arizonat/softroboticfish7/fish/mbed/README.md

===== saved_bin_files =====  
-- This contains bin files that were used for important experiments/demos.  

===== MCUXpress =====  
-- This is now an MCUXpresso (inherits from LPCXpresso) project for the fish mbed code. Install MCUXpresso IDE and import the workspace directory to edit. 

===== ZIP =====  
-- This contains compressed snapshots of previous mbed codebases.
