arizonat/softroboticfish7/fish/pi/ros/catkin_ws/src/fishstatecontroller/README.md

Defined Coordinates for fish: 
Positive x is the direction from the camera frame to the ball
Positive y is to the left in the camera frame
positive z is upward in the camera frame
