arizonat/softroboticfish7/fish/pi/ros/catkin_ws/src/fishstatecontroller/launch/raspicam_custom/Read Me.txt

Remember to adjust ObjectTracker init parameters for every frame res. change!
