arizonat/softroboticfish7/fish/pi/ros/catkin_ws/src/fishstatecontroller/graphs/lpf2.png

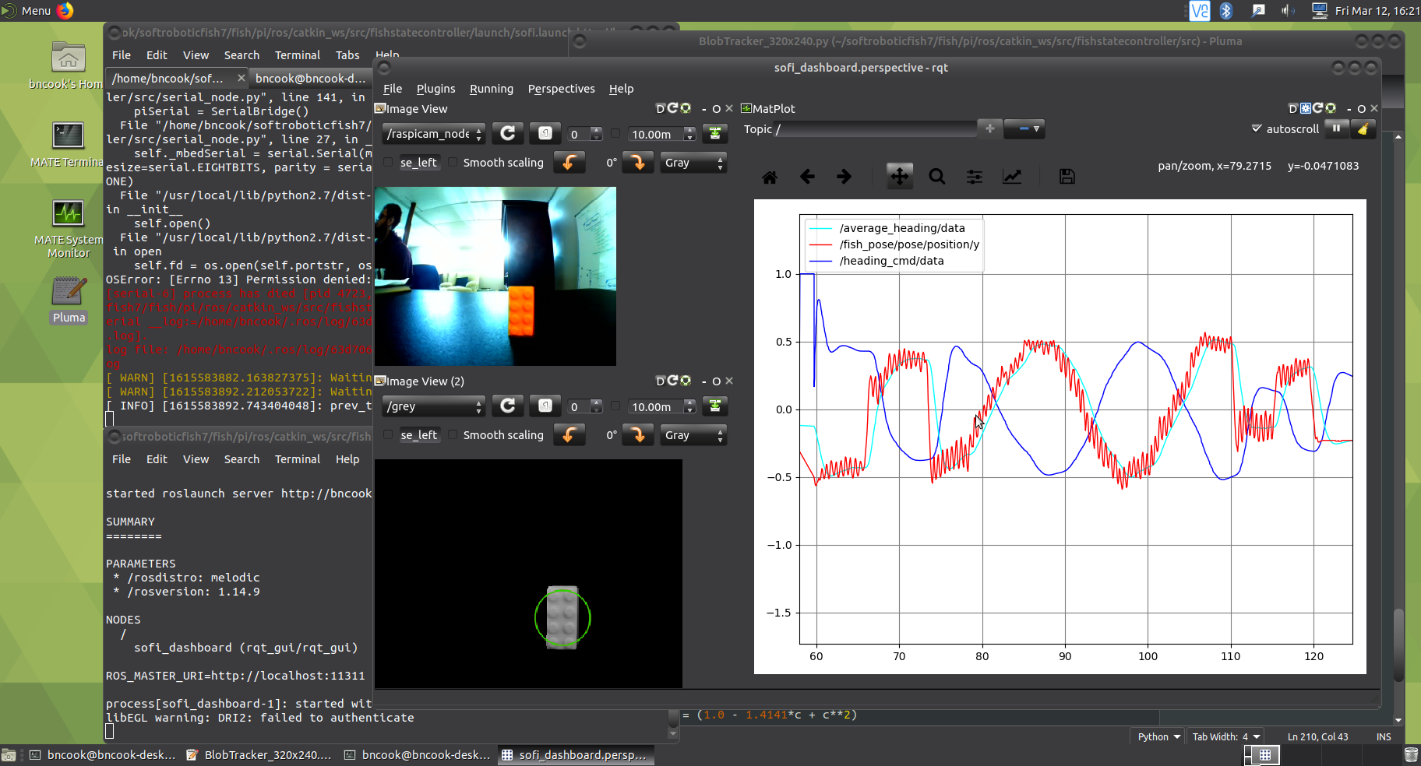
fish/pi/ros/catkin_ws/src/fishstatecontroller/graphs/lpf2.png
