arizonat/softroboticfish7/fish/pi/ros/catkin_ws/src/fishstatecontroller/graphs/lpf.png

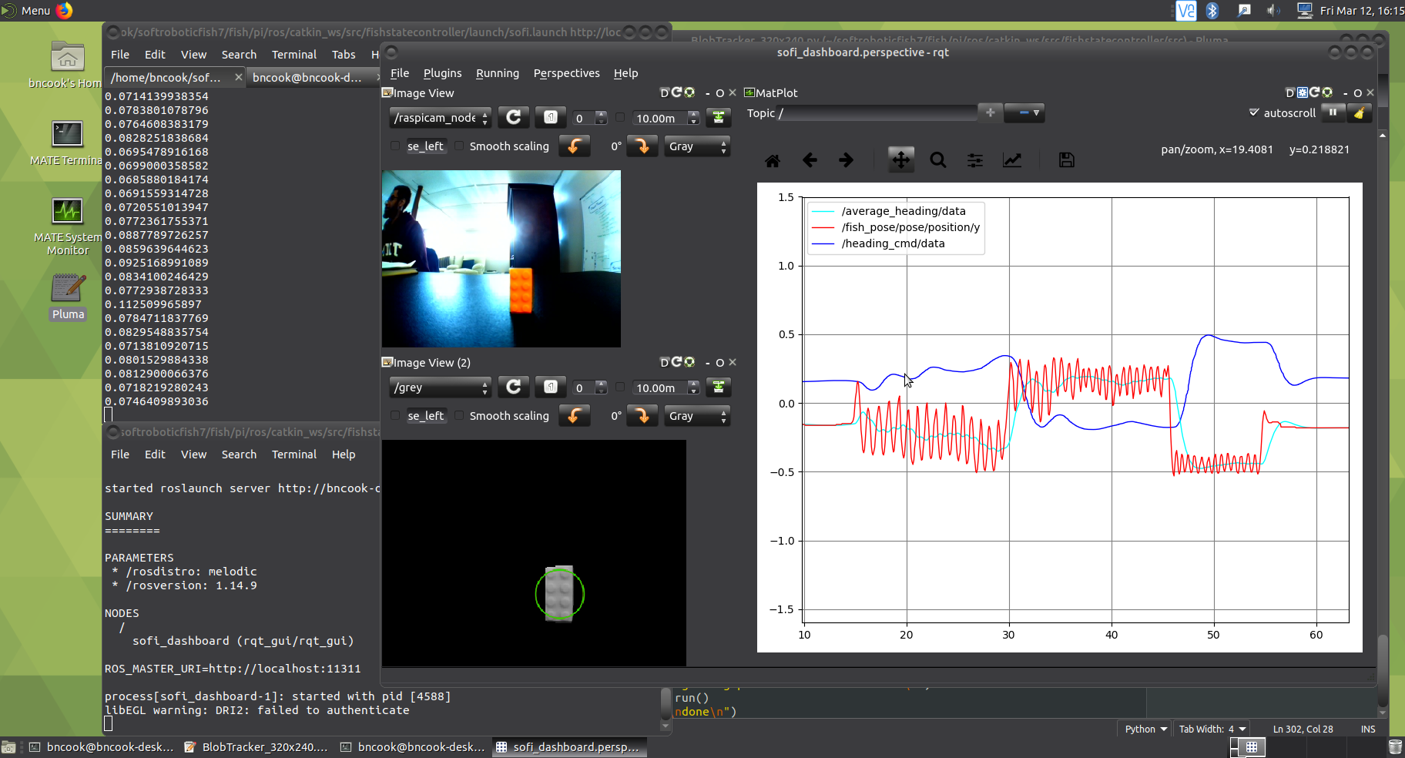
fish/pi/ros/catkin_ws/src/fishstatecontroller/graphs/lpf.png
