arizonat/softroboticfish7/fish/pi/ros/catkin_ws/src/fishstatecontroller/graphs/lpf_est_side.png

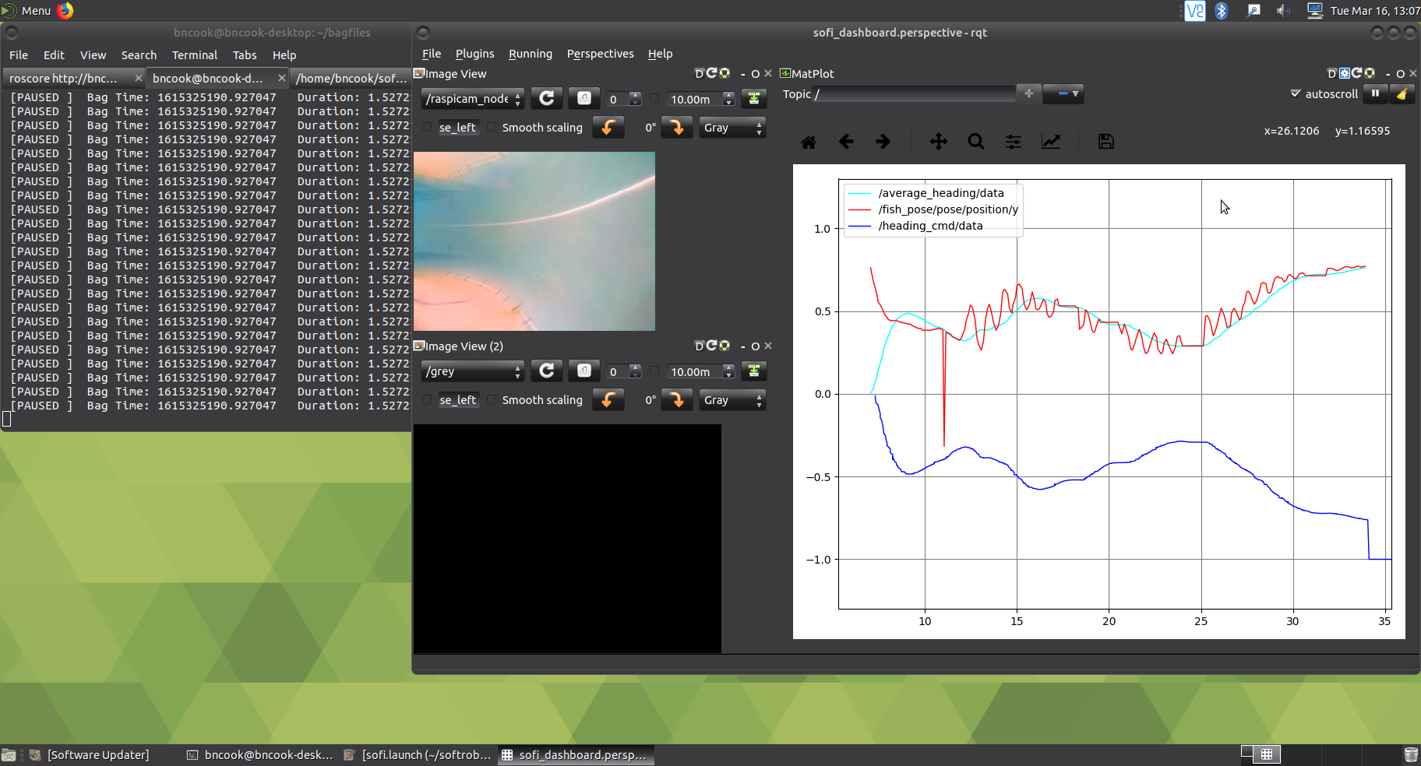
fish/pi/ros/catkin_ws/src/fishstatecontroller/graphs/lpf_est_side.png
