arizonat/softroboticfish7/fish/pi/ros/catkin_ws/src/fishstatecontroller/graphs/Screenshot at 2021-03-05 15-20-54.png

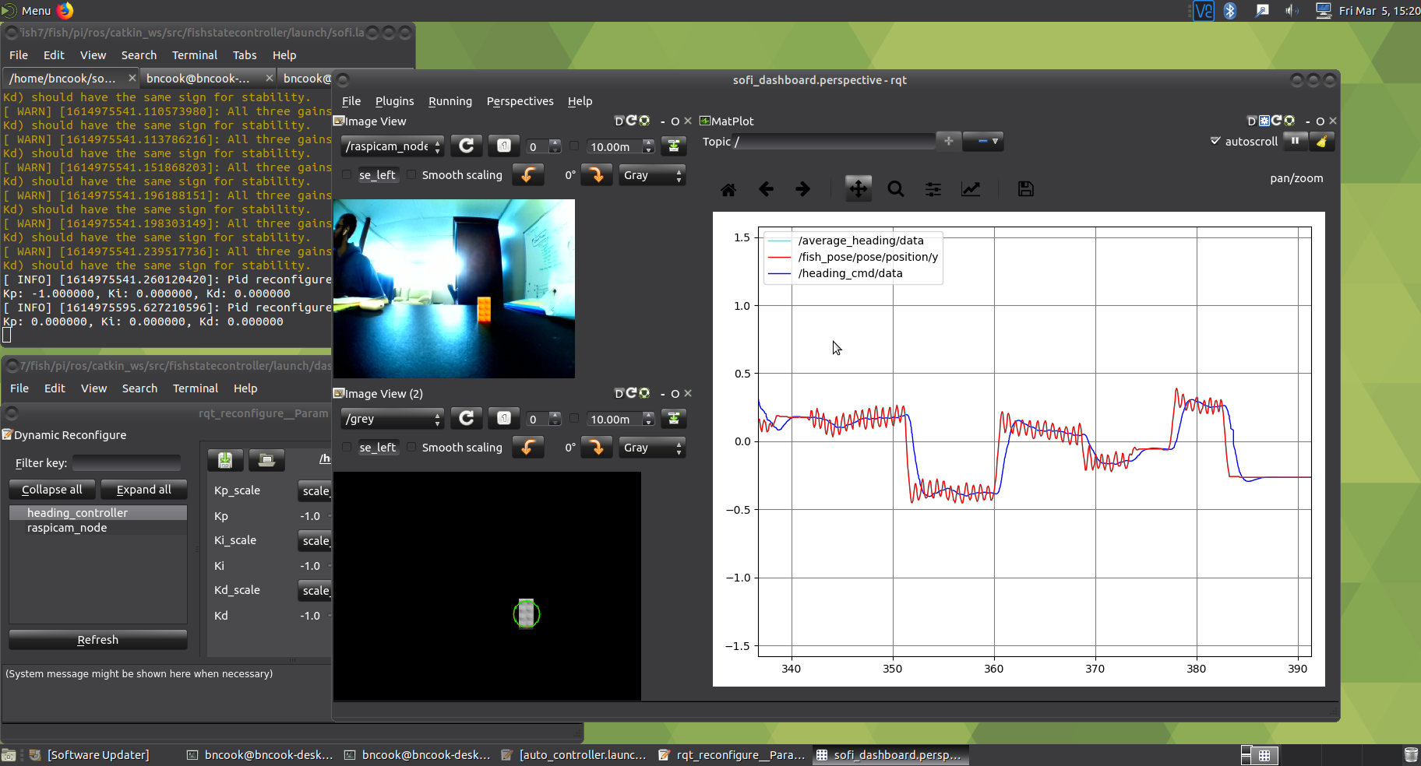
fish/pi/ros/catkin_ws/src/fishstatecontroller/graphs/Screenshot at 2021-03-05 15-20-54.png
