arizonat/softroboticfish7/hardware/Projects/SRF V2/V2_1 (DRV8801)/Images/Bottom.png

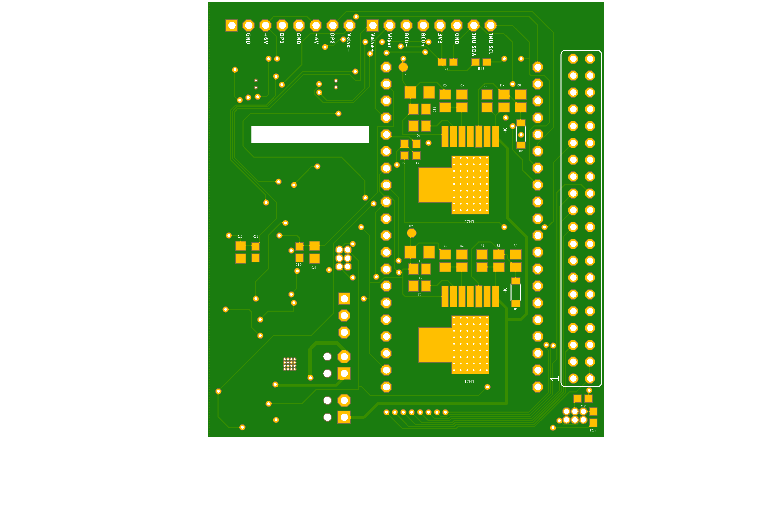
hardware/Projects/SRF V2/V2_1 (DRV8801)/Images/Bottom.png
