arizonat/softroboticfish7/hardware/Projects/SRF V2/V2_1 (DRV8801)/Images/Top.png

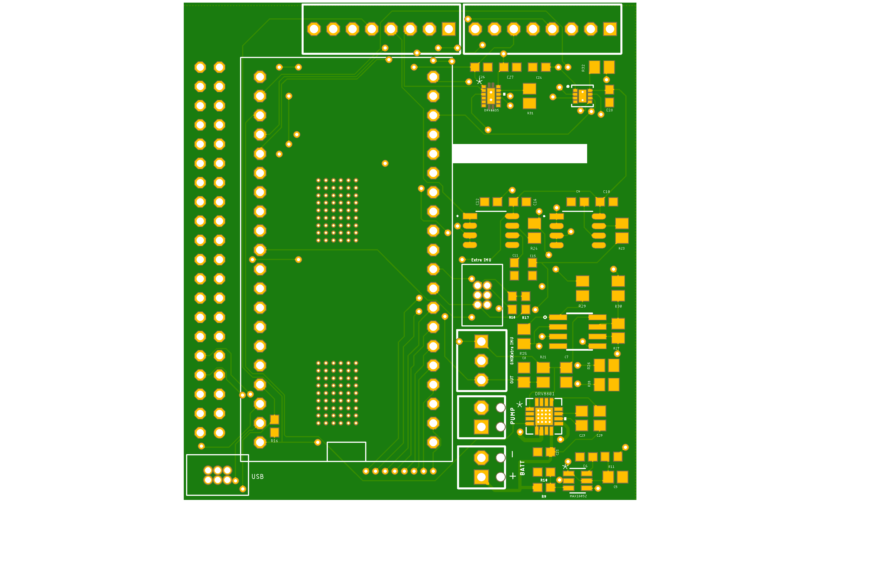
hardware/Projects/SRF V2/V2_1 (DRV8801)/Images/Top.png
