arizonat/softroboticfish7/hardware/Projects/SRF V2/V2_2 (MAX14870)/Long Motor Trace.png

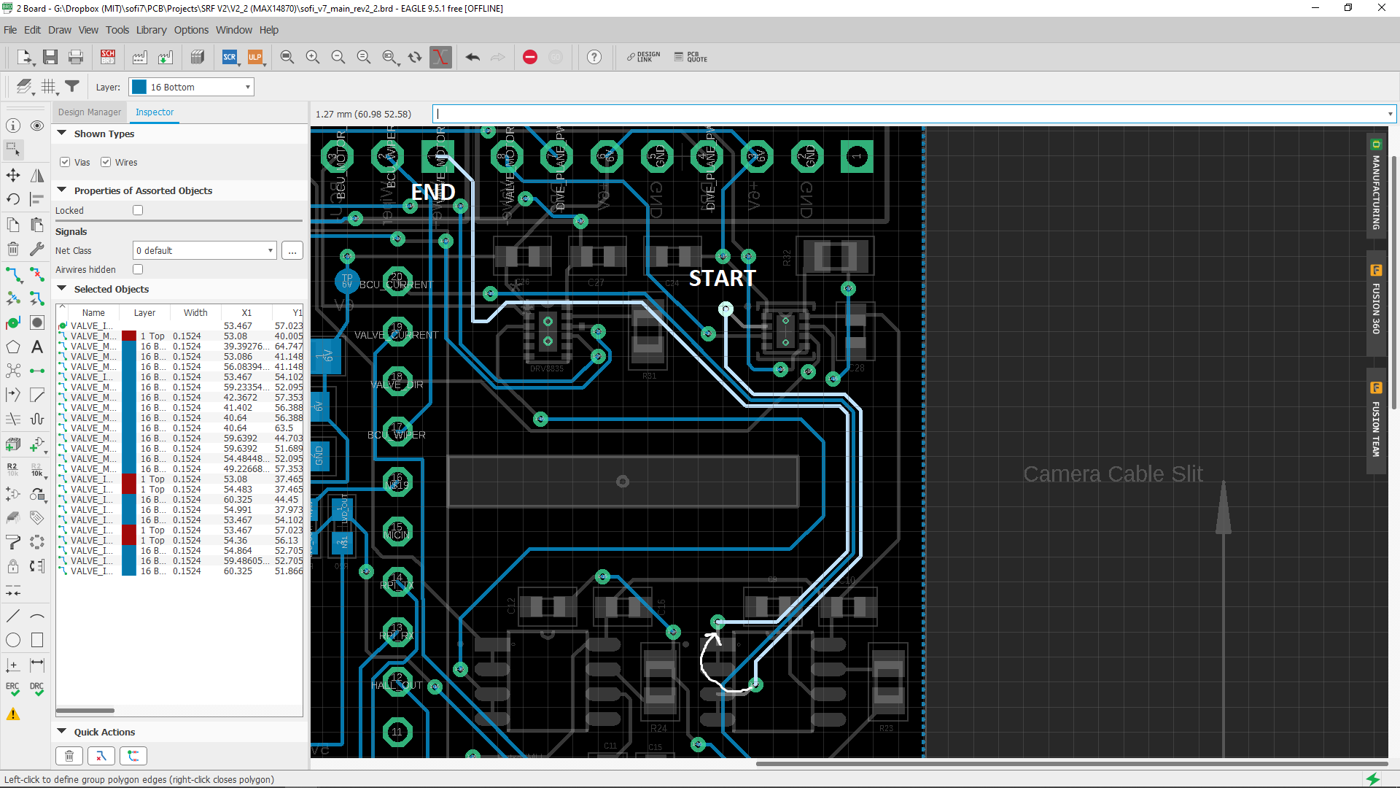
hardware/Projects/SRF V2/V2_2 (MAX14870)/Long Motor Trace.png
