arizonat/softroboticfish7/hardware/Projects/SRF V2/V2_2 (MAX14870)/Power Planes Shot Marked.jpg

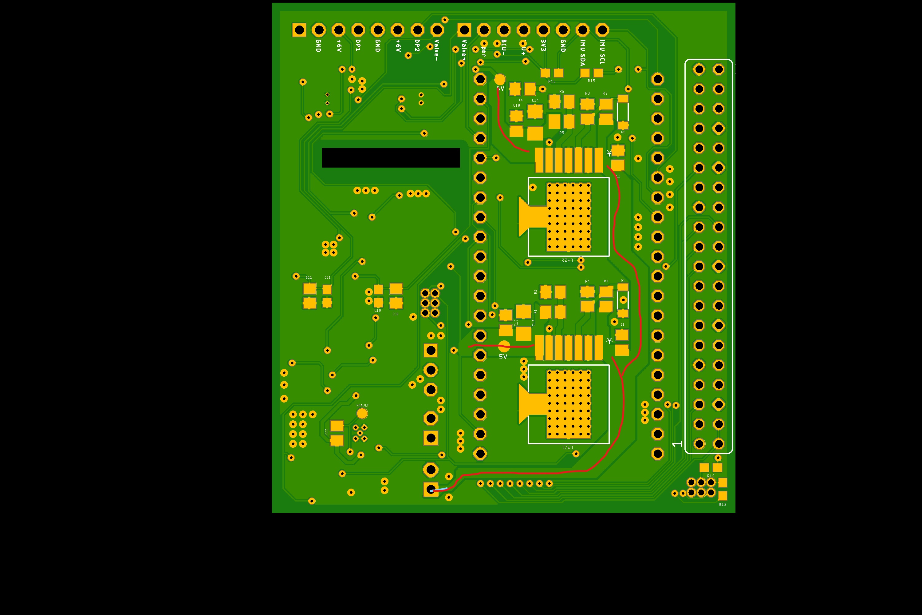
hardware/Projects/SRF V2/V2_2 (MAX14870)/Power Planes Shot Marked.jpg
