arizonat/softroboticfish7/hardware/Projects/SRF V2/V2_2 (MAX14870)/BOM/srfv2_2_BOM.xlsx

Manufacturer Part Number | Manufacturer | Digi-Key Part Number | Customer Reference | Reference Designator | Packaging | Part Status | Quantity | Unit Price | Extended Price | Quantity Available | Mfg Std Lead Time | Description | RoHS Status | Lead Free Status | REACH Status
ACS715LLCTR-20A-T | Allegro MicroSystems | 620-1230-1-ND |  | ACS715_BCU, ACS715_VALVE | Cut Tape (CT) | Not For New Designs | 2 | 6.52 | $13.04 | 3330 | Not Available | SENSOR CURRENT HALL 20A DC | ROHS3 Compliant | Contains lead | REACH Unaffected
45206-600230 | 3M | 3M15533-ND |  | USB | Tray | Active | 2 | 2.1 | $4.20 | 570 | 10 Weeks | CONN HEADER VERT 6POS 1.27MM | ROHS3 Compliant | Lead free | Not Available
DRV8835DSSR | Texas Instruments | 296-30391-2-ND |  | DRV8835 | Tape & Reel (TR) | Active | 1 | 0 | $0.00 | 21000 | 6 Weeks | IC MTR DRVR BIPOLAR 2-7V 12WSON | ROHS3 Compliant | Lead free | REACH Unaffected
DRV8838DSGT | Texas Instruments | 296-37539-1-ND |  | DRV8838 | Cut Tape (CT) | Active | 1 | 1.03 | $1.03 | 3356 | 6 Weeks | IC BRIDGE DRIVER PAR 8WSON | ROHS3 Compliant | Lead free | REACH Unaffected
1725656 | Phoenix Contact | 277-1273-ND |  | BATT, PUMP | Bulk | Active | 2 | 1.41 | $2.82 | 7140 | 7 Weeks | TERM BLK 2P SIDE ENT 2.54MM PCB | RoHS Compliant | Lead free | Not Available
MAX14870ETC+T | Maxim Integrated | MAX14870ETC+CT-ND |  | MAX14870 | Cut Tape (CT) | Active | 1 | 2.51 | $2.51 | 10600 | 7 Weeks | IC MOTOR DRIVER 4.5V-36V 12TDFN | ROHS3 Compliant | Lead free | REACH Unaffected
MAX16052AUT+T | Maxim Integrated | MAX16052AUT+TCT-ND |  | MAX16052 | Cut Tape (CT) | Active | 1 | 2.27 | $2.27 | 15019 | 6 Weeks | IC PWR MONITOR/SEQUENCER SOT23-6 | ROHS3 Compliant | Lead free | REACH Unaffected
PPPC202LFBN-RC | Sullins Connector Solutions | S7123-ND |  | RPI_HEADER | Tray | Active | 1 | 2.03 | $2.03 | 4207 | 5 Weeks | CONN HDR 40POS 0.1 GOLD PCB | ROHS3 Compliant | Lead free | REACH Unaffected
OM11043,598 | NXP USA Inc. | 568-4916-ND |  | MBED | Box | Active | 1 | 52.06 | $52.06 | 0 | 12 Weeks | MBED LPC176X DEV EVAL BRD | ROHS3 Compliant | Lead free | REACH Unaffected
OSTVN08A150 | On Shore Technology Inc. | ED10566-ND |  | U$4, U$5 | Bulk | Active | 2 | 2.01 | $4.02 | 2383 | 8 Weeks | TERM BLK 8P SIDE ENT 2.54MM PCB | ROHS3 Compliant | Lead free | REACH Unaffected
OSTVN03A150 | On Shore Technology Inc. | ED10562-ND |  | HALL | Bulk | Active | 1 | 0.88 | $0.88 | 12192 | 8 Weeks | TERM BLK 3P SIDE ENT 2.54MM PCB | ROHS3 Compliant | Lead free | REACH Unaffected
MMSZ4689-TP | Micro Commercial Co | MMSZ4689-TPMSCT-ND |  | D1, D2 | Cut Tape (CT) | Active | 2 | 0.17 | $0.34 | 41011 | 12 Weeks | DIODE ZENER 5.1V 500MW SOD123 | ROHS3 Compliant | Lead free | REACH Unaffected
LMZ23605TZE/NOPB | Texas Instruments | 296-35357-1-ND |  | LMZ1, LMZ2 | Cut Tape (CT) | Active | 2 | 11.76 | $23.52 | 3608 | 6 Weeks | DC DC CONVERTER 0.8-6V 5A | ROHS3 Compliant | Lead free | REACH Unaffected
LM358DT | STMicroelectronics | 497-1591-1-ND |  | LM1 | Cut Tape (CT) | Active | 1 | 0.4 | $0.40 | 95056 | 6 Weeks | IC OPAMP GP 2 CIRCUIT 8SO | ROHS3 Compliant | Lead free | REACH Unaffected
GRT21BR61E226ME13L | Murata Electronics | 490-12389-1-ND |  | C1, C3 | Cut Tape (CT) | Active | 2 | 0.54 | $1.08 | 208357 | 19 Weeks | CAP CER 22UF 25V X5R 0805 | ROHS3 Compliant | Lead free | Not Available
GRM31CR60J227ME11L | Murata Electronics | 490-13970-1-ND |  | C13, C14 | Cut Tape (CT) | Active | 2 | 1.42 | $2.84 | 169292 | 15 Weeks | CAP CER 220UF 6.3V X5R 1206 | ROHS3 Compliant | Lead free | Not Available
C0805C104K9RACTU | KEMET | 399-9155-1-ND |  | C17, C18 | Cut Tape (CT) | Active | 2 | 0.21 | $0.42 | 70826 | 8 Weeks | CAP CER 0.1UF 6.3V X7R 0805 | ROHS3 Compliant | Lead free | REACH Unaffected
TACL105K006RTA | AVX Corporation | 478-8774-1-ND |  | C19, C21 | Cut Tape (CT) | Active | 2 | 2.16 | $4.32 | 0 | 23 Weeks | CAP TANT 1UF 10% 6.3V 0603 | ROHS3 Compliant | Lead free | REACH Unaffected
C2012X7R1V474K125AB | TDK Corporation | 445-14549-1-ND |  | C2, C4 | Cut Tape (CT) | Not For New Designs | 2 | 0.27 | $0.54 | 416 | Not Available | CAP CER 0.47UF 35V X7R 0805 | ROHS3 Compliant | Lead free | REACH Unaffected
LD055C104JAB2A | AVX Corporation | 478-10963-1-ND |  | C20, C22, C7 | Cut Tape (CT) | Active | 3 | 0.65 | $1.95 | 24151 | 24 Weeks | CAP CER 0.1UF 50V X7R 0805 | RoHS non-compliant | Contains lead | REACH Unaffected
CL21F104ZBCNNNC | Samsung Electro-Mechanics | 1276-1007-1-ND |  | C5, C23 | Cut Tape (CT) | Active | 2 | 0.09 | $0.18 | 608050 | 22 Weeks | CAP CER 0.1UF 50V Y5V 0805 | ROHS3 Compliant | Lead free | REACH Unaffected
CL10C100JB8NFNC | Samsung Electro-Mechanics | 1276-2155-2-ND |  | C6 | Tape & Reel (TR) | Active | 1 | 0 | $0.00 | 84000 | 18 Weeks | CAP CER 10PF 50V C0G/NP0 0603 | ROHS3 Compliant | Lead free | REACH Unaffected
C0603C102J5GALTU | KEMET | 399-6346-1-ND |  | C9, C11 | Cut Tape (CT) | Active | 2 | 0.39 | $0.78 | 7653 | 29 Weeks | CAP CER 1000PF 50V C0G/NP0 0603 | RoHS non-compliant | Contains lead | REACH Unaffected
GCM188R71H104KA57J | Murata Electronics | 490-8020-1-ND |  | C10,C12, C16, C24, C26, C27, C28 | Cut Tape (CT) | Not For New Designs | 7 | 0.23 | $1.61 | 956922 | Not Available | CAP CER 0.1UF 50V X7R 0603 | ROHS3 Compliant | Lead free | Not Available
GRM188R61H225KE11D | Murata Electronics | 490-10733-1-ND |  | C12, C15 | Cut Tape (CT) | Active | 2 | 0.29 | $0.58 | 182633 | 15 Weeks | CAP CER 2.2UF 50V X5R 0603 | ROHS3 Compliant | Lead free | Not Available
VJ0805Y472KXACW1BC | Vishay Vitramon | 720-1605-1-ND |  | C8 | Cut Tape (CT) | Active | 1 | 0.25 | $0.25 | 92564 | 14 Weeks | CAP CER 4700PF 50V X7R 0805 | ROHS3 Compliant | Lead free | Not Available
ERJ-6ENF5621V | Panasonic Electronic Components | P5.62KCCT-ND |  | R1 | Cut Tape (CT) | Active | 1 | 0.09 | $0.09 | 23833 | 16 Weeks | RES SMD 5.62K OHM 1% 1/8W 0805 | ROHS3 Compliant | Lead free | REACH Unaffected
MCR03ERTJ563 | Rohm Semiconductor | RHM56KCGCT-ND |  | R11 | Cut Tape (CT) | Discontinued at Digi-Key | 1 | 0.09 | $0.09 | 766 | Not Available | RES SMD 56K OHM 5% 1/10W 0603 | ROHS3 Compliant | Lead free | REACH Unaffected
RC1608J152CS | Samsung Electro-Mechanics | 1276-5066-1-ND |  | R16 | Cut Tape (CT) | Discontinued at Digi-Key | 1 | 0.09 | $0.09 | 3780 | Not Available | RES SMD 1.5K OHM 5% 1/10W 0603 | ROHS3 Compliant | Lead free | REACH Unaffected
RC1608F330CS | Samsung Electro-Mechanics | 1276-4524-1-ND |  | R12, R13 | Cut Tape (CT) | Discontinued at Digi-Key | 2 | 0.09 | $0.18 | 153 | Not Available | RES SMD 33 OHM 1% 1/10W 0603 | ROHS3 Compliant | Lead free | REACH Unaffected
KTR03EZPF10R0 | Rohm Semiconductor | RHM10.0AYCT-ND |  | R19, R20 | Cut Tape (CT) | Active | 2 | 0.12 | $0.24 | 2215 | 10 Weeks | RES SMD 10 OHM 1% 1/10W 0603 | ROHS3 Compliant | Lead free | REACH Unaffected
ERJ-6ENF1071V | Panasonic Electronic Components | P1.07KCCT-ND |  | R2 | Cut Tape (CT) | Active | 1 | 0.09 | $0.09 | 35297 | 16 Weeks | RES SMD 1.07K OHM 1% 1/8W 0805 | ROHS3 Compliant | Lead free | REACH Unaffected
CRS0805-FX-1002ELF | Bourns Inc. | CRS0805-FX-1002ELFCT-ND |  | R21, R32 | Cut Tape (CT) | Active | 2 | 0.32 | $0.64 | 6554 | 16 Weeks | RES SMD 10K OHM 1% 1/4W 0805 | ROHS3 Compliant | Lead free | REACH Unaffected
ERJ-6ENF7502V | Panasonic Electronic Components | P75.0KCCT-ND |  | R29, R30, R24, R23 | Cut Tape (CT) | Active | 4 | 0.09 | $0.36 | 62375 | 16 Weeks | RES SMD 75K OHM 1% 1/8W 0805 | ROHS3 Compliant | Lead free | REACH Unaffected
ERA-6AEB4222V | Panasonic Electronic Components | P42.2KDACT-ND |  | R3, R7 | Cut Tape (CT) | Active | 2 | 0.29 | $0.58 | 11630 | 12 Weeks | RES 42.2K OHM 0.1% 1/8W 0805 | ROHS3 Compliant | Lead free | REACH Unaffected
ERJ-6ENF1272V | Panasonic Electronic Components | P12.7KCCT-ND |  | R4, R8 | Cut Tape (CT) | Active | 2 | 0.09 | $0.18 | 44414 | 16 Weeks | RES SMD 12.7K OHM 1% 1/8W 0805 | ROHS3 Compliant | Lead free | REACH Unaffected
RC0603FR-072K2L | Yageo | 311-2.20KHRCT-ND |  | R14, R15, R17, R18 | Cut Tape (CT) | Active | 4 | 0.09 | $0.36 | 6758086 | 24 Weeks | RES SMD 2.2K OHM 1% 1/10W 0603 | ROHS3 Compliant | Lead free | REACH Unaffected
ERJ-6ENF1101V | Panasonic Electronic Components | P1.10KCCT-ND |  | R26, R31, R28 | Cut Tape (CT) | Active | 3 | 0.09 | $0.27 | 47269 | 16 Weeks | RES SMD 1.1K OHM 1% 1/8W 0805 | ROHS3 Compliant | Lead free | REACH Unaffected
ERJ-6ENF6801V | Panasonic Electronic Components | P6.80KCCT-ND |  | R25, R27 | Cut Tape (CT) | Active | 2 | 0.09 | $0.18 | 41389 | 16 Weeks | RES SMD 6.8K OHM 1% 1/8W 0805 | ROHS3 Compliant | Lead free | REACH Unaffected
TNPW0603130KBEEA | Vishay Dale | 541-3585-1-ND |  | R10 | Cut Tape (CT) | Active | 1 | 0.53 | $0.53 | 2644 | 13 Weeks | RES 130K OHM 0.1% 1/10W 0603 | ROHS3 Compliant | Lead free | Not Available
CRCW06033M83FKEA | Vishay Dale | 541-3.83MHCT-ND |  | R9 | Cut Tape (CT) | Active | 1 | 0.1 | $0.10 | 23740 | 14 Weeks | RES SMD 3.83M OHM 1% 1/10W 0603 | ROHS3 Compliant | Lead free | Not Available
ERA-6AEB1542V | Panasonic Electronic Components | P15.4KDACT-ND |  | R5 | Cut Tape (CT) | Active | 1 | 0.29 | $0.29 | 9216 | 12 Weeks | RES 15.4K OHM 0.1% 1/8W 0805 | ROHS3 Compliant | Lead free | REACH Unaffected
CRCW08052K37FKEA | Vishay Dale | 541-2.37KCCT-ND |  | R6 | Cut Tape (CT) | Active | 1 | 0.1 | $0.10 | 16388 | 11 Weeks | RES SMD 2.37K OHM 1% 1/8W 0805 | ROHS3 Compliant | Lead free | Not Available
