arizonat/softroboticfish7/hardware/Projects/SRF V2/V2_1 (DRV8801)/DXF Exports/sofi_v7_main_rev2_1.dxf

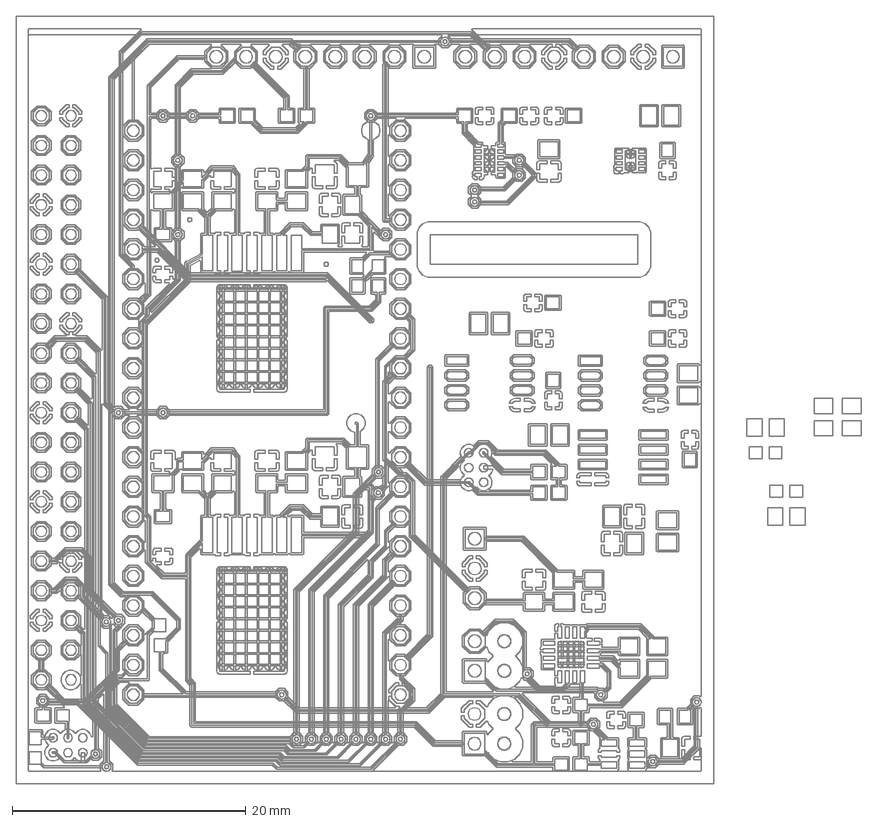
[picture p10: CAD file, 2020-06-12]
hardware/Projects/SRF V2/V2_1 (DRV8801)/DXF Exports/sofi_v7_main_rev2_1.dxf
72.3 x 65.7 mm
