arizonat/softroboticfish7/fish/pi/Serial_Test/dev_list.txt

total 0
crw-rw----+ 1 root audio    14,  12 Jan 28  2018 adsp
crw-rw----+ 1 root audio    14,   4 Jan 28  2018 audio
crw-r--r--  1 root root     10, 235 Jan 28  2018 autofs
drwxr-xr-x  2 root root        5220 Jun 25 16:54 block
crw-------  1 root root     10, 234 Jan 28  2018 btrfs-control
drwxr-xr-x  3 root root          60 Dec 31  1969 bus
crw-------  1 root root     10,  62 Jan 28  2018 cachefiles
drwxr-xr-x  2 root root        2740 Jun 25 16:54 char
crw-------  1 root root      5,   1 Jun 25 15:22 console
crw-------  1 root root     10,  60 Jan 28  2018 cpu_dma_latency
crw-------  1 root root     10, 203 Jan 28  2018 cuse
drwxr-xr-x  7 root root         140 Dec 31  1969 disk
crw-rw----+ 1 root audio    14,   3 Jan 28  2018 dsp
crw-------  1 root root     10,  61 Jan 28  2018 ecryptfs
crw-rw----  1 root video    29,   0 Jan 28  2018 fb0
lrwxrwxrwx  1 root root          13 Dec 31  1969 fd -> /proc/self/fd
crw-rw-rw-  1 root root      1,   7 Jan 28  2018 full
crw-rw-rw-  1 root root     10, 229 Jun 25 15:22 fuse
crw-rw----  1 root gpio    254,   0 Jan 28  2018 gpiochip0
crw-rw----  1 root gpio    254,   1 Jan 28  2018 gpiochip1
crw-rw----  1 root gpio    244,   0 Jan 28  2018 gpiomem
crw-------  1 root root     10, 183 Jan 28  2018 hwrng
lrwxrwxrwx  1 root root          25 Jan 28  2018 initctl -> /run/systemd/initctl/fifo
drwxr-xr-x  2 root root          60 Jun 25 15:58 input
crw-r--r--  1 root root      1,  11 Jan 28  2018 kmsg
lrwxrwxrwx  1 root root          28 Jan 28  2018 log -> /run/systemd/journal/dev-log
brw-rw----  1 root disk      7,   0 Jan 28  2018 loop0
brw-rw----  1 root disk      7,   1 Jan 28  2018 loop1
brw-rw----  1 root disk      7,  10 Jan 28  2018 loop10
brw-rw----  1 root disk      7, 100 Jan 28  2018 loop100
brw-rw----  1 root disk      7, 101 Jan 28  2018 loop101
brw-rw----  1 root disk      7, 102 Jan 28  2018 loop102
brw-rw----  1 root disk      7, 103 Jan 28  2018 loop103
brw-rw----  1 root disk      7, 104 Jan 28  2018 loop104
brw-rw----  1 root disk      7, 105 Jan 28  2018 loop105
brw-rw----  1 root disk      7, 106 Jan 28  2018 loop106
brw-rw----  1 root disk      7, 107 Jan 28  2018 loop107
brw-rw----  1 root disk      7, 108 Jan 28  2018 loop108
brw-rw----  1 root disk      7, 109 Jan 28  2018 loop109
brw-rw----  1 root disk      7,  11 Jun 25 15:22 loop11
brw-rw----  1 root disk      7, 110 Jan 28  2018 loop110
brw-rw----  1 root disk      7, 111 Jan 28  2018 loop111
brw-rw----  1 root disk      7, 112 Jan 28  2018 loop112
brw-rw----  1 root disk      7, 113 Jan 28  2018 loop113
brw-rw----  1 root disk      7, 114 Jan 28  2018 loop114
brw-rw----  1 root disk      7, 115 Jan 28  2018 loop115
brw-rw----  1 root disk      7, 116 Jan 28  2018 loop116
brw-rw----  1 root disk      7, 117 Jan 28  2018 loop117
brw-rw----  1 root disk      7, 118 Jan 28  2018 loop118
brw-rw----  1 root disk      7, 119 Jan 28  2018 loop119
brw-rw----  1 root disk      7,  12 Jan 28  2018 loop12
brw-rw----  1 root disk      7, 120 Jan 28  2018 loop120
brw-rw----  1 root disk      7, 121 Jan 28  2018 loop121
brw-rw----  1 root disk      7, 122 Jan 28  2018 loop122
brw-rw----  1 root disk      7, 123 Jan 28  2018 loop123
brw-rw----  1 root disk      7, 124 Jan 28  2018 loop124
brw-rw----  1 root disk      7, 125 Jan 28  2018 loop125
brw-rw----  1 root disk      7, 126 Jan 28  2018 loop126
brw-rw----  1 root disk      7, 127 Jan 28  2018 loop127
brw-rw----  1 root disk      7, 128 Jan 28  2018 loop128
brw-rw----  1 root disk      7, 129 Jan 28  2018 loop129
brw-rw----  1 root disk      7,  13 Jan 28  2018 loop13
brw-rw----  1 root disk      7, 130 Jan 28  2018 loop130
brw-rw----  1 root disk      7, 131 Jan 28  2018 loop131
brw-rw----  1 root disk      7, 132 Jan 28  2018 loop132
brw-rw----  1 root disk      7, 133 Jan 28  2018 loop133
brw-rw----  1 root disk      7, 134 Jan 28  2018 loop134
brw-rw----  1 root disk      7, 135 Jan 28  2018 loop135
brw-rw----  1 root disk      7, 136 Jan 28  2018 loop136
brw-rw----  1 root disk      7, 137 Jan 28  2018 loop137
brw-rw----  1 root disk      7, 138 Jan 28  2018 loop138
brw-rw----  1 root disk      7, 139 Jan 28  2018 loop139
brw-rw----  1 root disk      7,  14 Jan 28  2018 loop14
brw-rw----  1 root disk      7, 140 Jan 28  2018 loop140
brw-rw----  1 root disk      7, 141 Jan 28  2018 loop141
brw-rw----  1 root disk      7, 142 Jan 28  2018 loop142
brw-rw----  1 root disk      7, 143 Jan 28  2018 loop143
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
brw-rw----  1 root disk      7,  75 Jan 28  2018 loop75
brw-rw----  1 root disk      7,  76 Jan 28  2018 loop76
brw-rw----  1 root disk      7,  77 Jan 28  2018 loop77
brw-rw----  1 root disk      7,  78 Jan 28  2018 loop78
brw-rw----  1 root disk      7,  79 Jan 28  2018 loop79
brw-rw----  1 root disk      7,   8 Jan 28  2018 loop8
brw-rw----  1 root disk      7,  80 Jan 28  2018 loop80
brw-rw----  1 root disk      7,  81 Jan 28  2018 loop81
brw-rw----  1 root disk      7,  82 Jan 28  2018 loop82
brw-rw----  1 root disk      7,  83 Jan 28  2018 loop83
brw-rw----  1 root disk      7,  84 Jan 28  2018 loop84
brw-rw----  1 root disk      7,  85 Jan 28  2018 loop85
brw-rw----  1 root disk      7,  86 Jan 28  2018 loop86
brw-rw----  1 root disk      7,  87 Jan 28  2018 loop87
brw-rw----  1 root disk      7,  88 Jan 28  2018 loop88
brw-rw----  1 root disk      7,  89 Jan 28  2018 loop89
brw-rw----  1 root disk      7,   9 Jan 28  2018 loop9
brw-rw----  1 root disk      7,  90 Jan 28  2018 loop90
brw-rw----  1 root disk      7,  91 Jan 28  2018 loop91
brw-rw----  1 root disk      7,  92 Jan 28  2018 loop92
brw-rw----  1 root disk      7,  93 Jan 28  2018 loop93
brw-rw----  1 root disk      7,  94 Jan 28  2018 loop94
brw-rw----  1 root disk      7,  95 Jan 28  2018 loop95
brw-rw----  1 root disk      7,  96 Jan 28  2018 loop96
brw-rw----  1 root disk      7,  97 Jan 28  2018 loop97
brw-rw----  1 root disk      7,  98 Jan 28  2018 loop98
brw-rw----  1 root disk      7,  99 Jan 28  2018 loop99
crw-rw----  1 root disk     10, 237 Jan 28  2018 loop-control
drwxr-xr-x  2 root root          60 Dec 31  1969 mapper
crw-r-----  1 root kmem      1,   1 Jan 28  2018 mem
crw-------  1 root root     10,  57 Jan 28  2018 memory_bandwidth
crw-rw----+ 1 root audio    14,   0 Jan 28  2018 mixer
brw-rw----  1 root disk    179,   0 Jan 28  2018 mmcblk0
brw-rw----  1 root disk    179,   1 Jan 28  2018 mmcblk0p1
brw-rw----  1 root disk    179,   2 Jan 28  2018 mmcblk0p2
drwxrwxrwt  2 root root          40 Dec 31  1969 mqueue
drwxr-xr-x  2 root root          60 Jan 28  2018 net
crw-------  1 root root     10,  59 Jan 28  2018 network_latency
crw-------  1 root root     10,  58 Jan 28  2018 network_throughput
crw-rw-rw-  1 root root      1,   3 Jan 28  2018 null
crw-------  1 root root    108,   0 Jan 28  2018 ppp
crw-------  1 root root     10,   1 Jan 28  2018 psaux
crw-rw-rw-  1 root tty       5,   2 Jun 25 16:57 ptmx
drwxr-xr-x  2 root root           0 Dec 31  1969 pts
crw-rw-rw-  1 root root      1,   8 Jan 28  2018 random
drwxr-xr-x  2 root root          60 Dec 31  1969 raw
crw-rw-r--+ 1 root netdev   10,  63 Jan 28  2018 rfkill
crw-rw----+ 1 root audio    14,   1 Jan 28  2018 sequencer
crw-rw----+ 1 root audio    14,   8 Jan 28  2018 sequencer2
lrwxrwxrwx  1 root root           5 Jan 28  2018 serial0 -> ttyS0
lrwxrwxrwx  1 root root           7 Jan 28  2018 serial1 -> ttyAMA0
drwxrwxrwt  2 root root          40 Jun 25 15:23 shm
crw-------  1 root root     10, 231 Jan 28  2018 snapshot
drwxr-xr-x  3 root root         160 Jan 28  2018 snd
lrwxrwxrwx  1 root root          15 Dec 31  1969 stderr -> /proc/self/fd/2
lrwxrwxrwx  1 root root          15 Dec 31  1969 stdin -> /proc/self/fd/0
lrwxrwxrwx  1 root root          15 Dec 31  1969 stdout -> /proc/self/fd/1
crw-rw-rw-  1 root tty       5,   0 Jun 25 16:52 tty
crw--w----  1 root tty       4,   0 Jan 28  2018 tty0
crw--w----  1 root tty       4,   1 Jun 25 15:22 tty1
crw--w----  1 root tty       4,  10 Jan 28  2018 tty10
crw--w----  1 root tty       4,  11 Jan 28  2018 tty11
crw--w----  1 root tty       4,  12 Jan 28  2018 tty12
crw--w----  1 root tty       4,  13 Jan 28  2018 tty13
crw--w----  1 root tty       4,  14 Jan 28  2018 tty14
crw--w----  1 root tty       4,  15 Jan 28  2018 tty15
crw--w----  1 root tty       4,  16 Jan 28  2018 tty16
crw--w----  1 root tty       4,  17 Jan 28  2018 tty17
crw--w----  1 root tty       4,  18 Jan 28  2018 tty18
crw--w----  1 root tty       4,  19 Jan 28  2018 tty19
crw--w----  1 root tty       4,   2 Jan 28  2018 tty2
crw--w----  1 root tty       4,  20 Jan 28  2018 tty20
crw--w----  1 root tty       4,  21 Jan 28  2018 tty21
crw--w----  1 root tty       4,  22 Jan 28  2018 tty22
crw--w----  1 root tty       4,  23 Jan 28  2018 tty23
crw--w----  1 root tty       4,  24 Jan 28  2018 tty24
crw--w----  1 root tty       4,  25 Jan 28  2018 tty25
crw--w----  1 root tty       4,  26 Jan 28  2018 tty26
crw--w----  1 root tty       4,  27 Jan 28  2018 tty27
crw--w----  1 root tty       4,  28 Jan 28  2018 tty28
crw--w----  1 root tty       4,  29 Jan 28  2018 tty29
crw--w----  1 root tty       4,   3 Jan 28  2018 tty3
crw--w----  1 root tty       4,  30 Jan 28  2018 tty30
crw--w----  1 root tty       4,  31 Jan 28  2018 tty31
crw--w----  1 root tty       4,  32 Jan 28  2018 tty32
crw--w----  1 root tty       4,  33 Jan 28  2018 tty33
crw--w----  1 root tty       4,  34 Jan 28  2018 tty34
crw--w----  1 root tty       4,  35 Jan 28  2018 tty35
crw--w----  1 root tty       4,  36 Jan 28  2018 tty36
crw--w----  1 root tty       4,  37 Jan 28  2018 tty37
crw--w----  1 root tty       4,  38 Jan 28  2018 tty38
crw--w----  1 root tty       4,  39 Jan 28  2018 tty39
crw--w----  1 root tty       4,   4 Jan 28  2018 tty4
crw--w----  1 root tty       4,  40 Jan 28  2018 tty40
crw--w----  1 root tty       4,  41 Jan 28  2018 tty41
crw--w----  1 root tty       4,  42 Jan 28  2018 tty42
crw--w----  1 root tty       4,  43 Jan 28  2018 tty43
crw--w----  1 root tty       4,  44 Jan 28  2018 tty44
crw--w----  1 root tty       4,  45 Jan 28  2018 tty45
crw--w----  1 root tty       4,  46 Jan 28  2018 tty46
crw--w----  1 root tty       4,  47 Jan 28  2018 tty47
crw--w----  1 root tty       4,  48 Jan 28  2018 tty48
crw--w----  1 root tty       4,  49 Jan 28  2018 tty49
crw--w----  1 root tty       4,   5 Jan 28  2018 tty5
crw--w----  1 root tty       4,  50 Jan 28  2018 tty50
crw--w----  1 root tty       4,  51 Jan 28  2018 tty51
crw--w----  1 root tty       4,  52 Jan 28  2018 tty52
crw--w----  1 root tty       4,  53 Jan 28  2018 tty53
crw--w----  1 root tty       4,  54 Jan 28  2018 tty54
crw--w----  1 root tty       4,  55 Jan 28  2018 tty55
crw--w----  1 root tty       4,  56 Jan 28  2018 tty56
crw--w----  1 root tty       4,  57 Jan 28  2018 tty57
crw--w----  1 root tty       4,  58 Jan 28  2018 tty58
crw--w----  1 root tty       4,  59 Jan 28  2018 tty59
crw--w----  1 root tty       4,   6 Jan 28  2018 tty6
crw--w----  1 root tty       4,  60 Jan 28  2018 tty60
crw--w----  1 root tty       4,  61 Jan 28  2018 tty61
crw--w----  1 root tty       4,  62 Jan 28  2018 tty62
crw--w----  1 root tty       4,  63 Jan 28  2018 tty63
crw--w----  1 root tty       4,   7 Jun 25 15:22 tty7
crw--w----  1 root tty       4,   8 Jan 28  2018 tty8
crw--w----  1 root tty       4,   9 Jan 28  2018 tty9
crw-rw----  1 root dialout 204,  64 Jun 25 15:22 ttyAMA0
crw-------  1 root root      5,   3 Jan 28  2018 ttyprintk
crw--w----  1 root tty       4,  64 Jun 25 16:30 ttyS0
crw-------  1 root root     10, 239 Jan 28  2018 uhid
crw-------  1 root root     10, 223 Jan 28  2018 uinput
crw-rw-rw-  1 root root      1,   9 Jan 28  2018 urandom
crw-------  1 root root     10, 240 Jan 28  2018 userio
crw-rw----  1 root video   240,   0 Jan 28  2018 vchiq
crw-rw----  1 root video   245,   0 Jan 28  2018 vcio
crw-------  1 root root    246,   0 Jan 28  2018 vc-mem
crw-rw----  1 root tty       7,   0 Jan 28  2018 vcs
crw-rw----  1 root tty       7,   1 Jan 28  2018 vcs1
crw-rw----  1 root tty       7,   2 Jan 28  2018 vcs2
crw-rw----  1 root tty       7,   3 Jan 28  2018 vcs3
crw-rw----  1 root tty       7,   4 Jan 28  2018 vcs4
crw-rw----  1 root tty       7,   5 Jan 28  2018 vcs5
crw-rw----  1 root tty       7,   6 Jan 28  2018 vcs6
crw-rw----  1 root tty       7,   7 Jun 25 15:22 vcs7
crw-rw----  1 root tty       7, 128 Jan 28  2018 vcsa
crw-rw----  1 root tty       7, 129 Jan 28  2018 vcsa1
crw-rw----  1 root tty       7, 130 Jan 28  2018 vcsa2
crw-rw----  1 root tty       7, 131 Jan 28  2018 vcsa3
crw-rw----  1 root tty       7, 132 Jan 28  2018 vcsa4
crw-rw----  1 root tty       7, 133 Jan 28  2018 vcsa5
crw-rw----  1 root tty       7, 134 Jan 28  2018 vcsa6
crw-rw----  1 root tty       7, 135 Jun 25 15:22 vcsa7
crw-rw----  1 root video   241,   0 Jan 28  2018 vcsm
crw-------  1 root root     10, 137 Jan 28  2018 vhci
crw-------  1 root root     10, 238 Jan 28  2018 vhost-net
crw-------  1 root root     10, 241 Jan 28  2018 vhost-vsock
crw-------  1 root root     10, 130 Jan 28  2018 watchdog
crw-------  1 root root    248,   0 Jan 28  2018 watchdog0
crw-rw-rw-  1 root root      1,   5 Jan 28  2018 zero
