arizonat/softroboticfish7/fish/pi/ros/catkin_ws/src/fishstatecontroller/graphs/2_2_21_test2.png

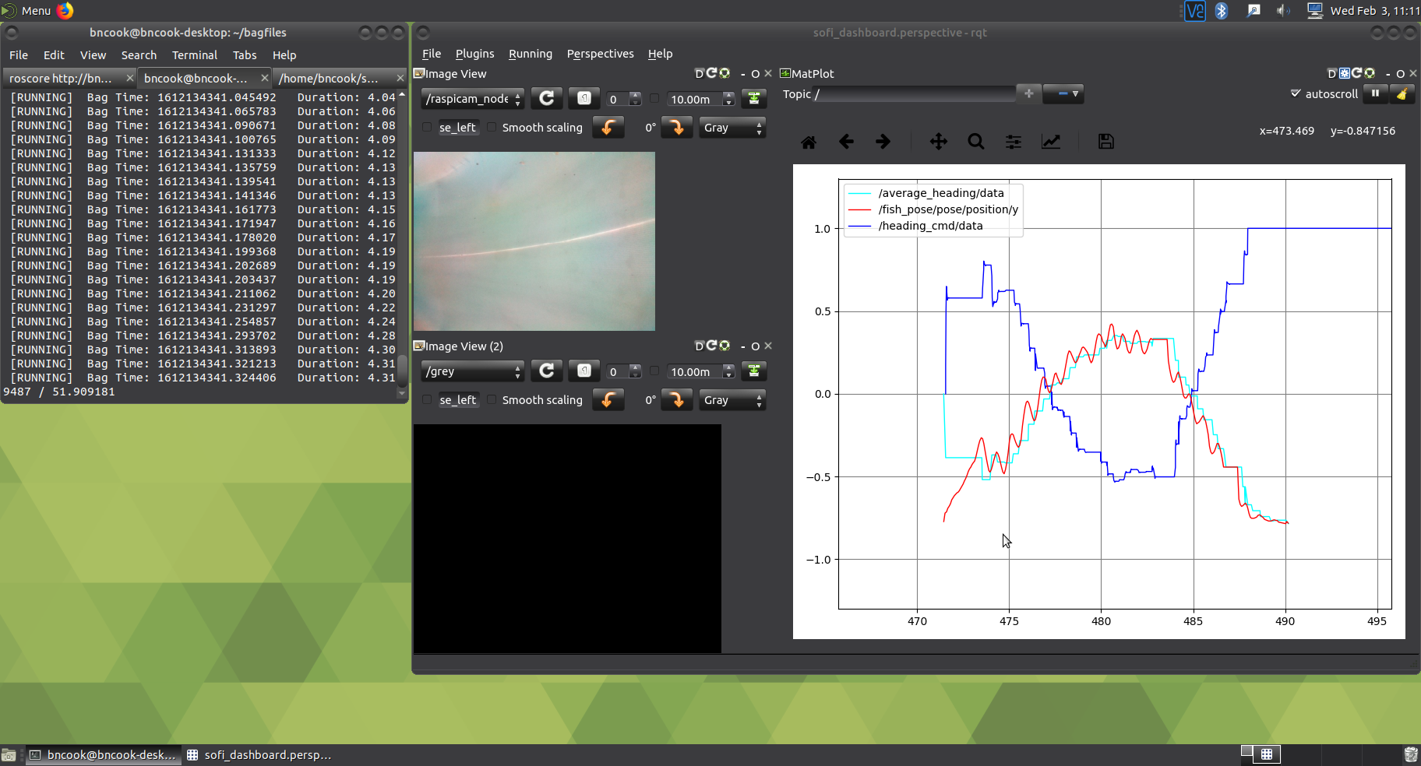
fish/pi/ros/catkin_ws/src/fishstatecontroller/graphs/2_2_21_test2.png
