arizonat/softroboticfish7/fish/pi/ros/catkin_ws/src/fishstatecontroller/graphs/new_test1_tracking.png

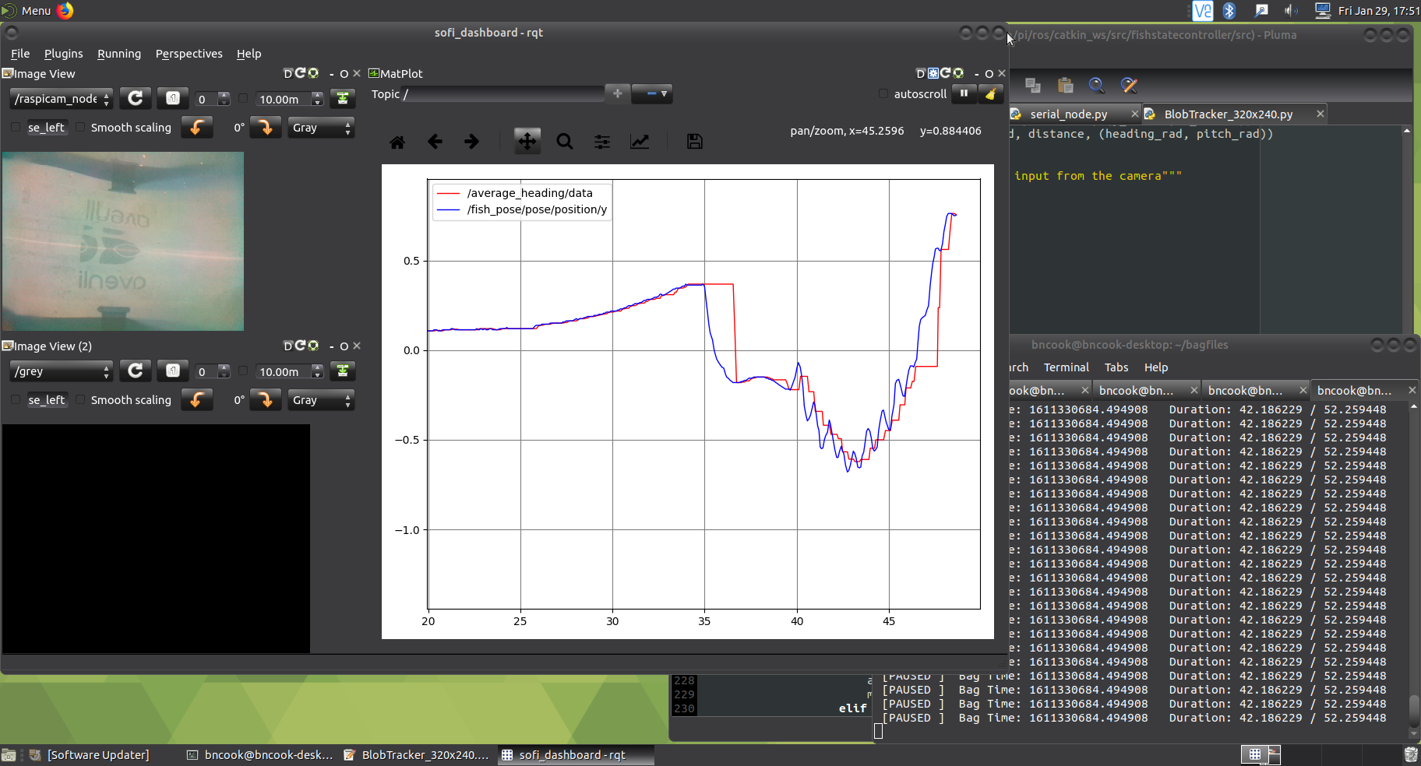
fish/pi/ros/catkin_ws/src/fishstatecontroller/graphs/new_test1_tracking.png
