arizonat/softroboticfish7/fish/pi/ros/catkin_ws/src/fishstatecontroller/graphs/test1.png

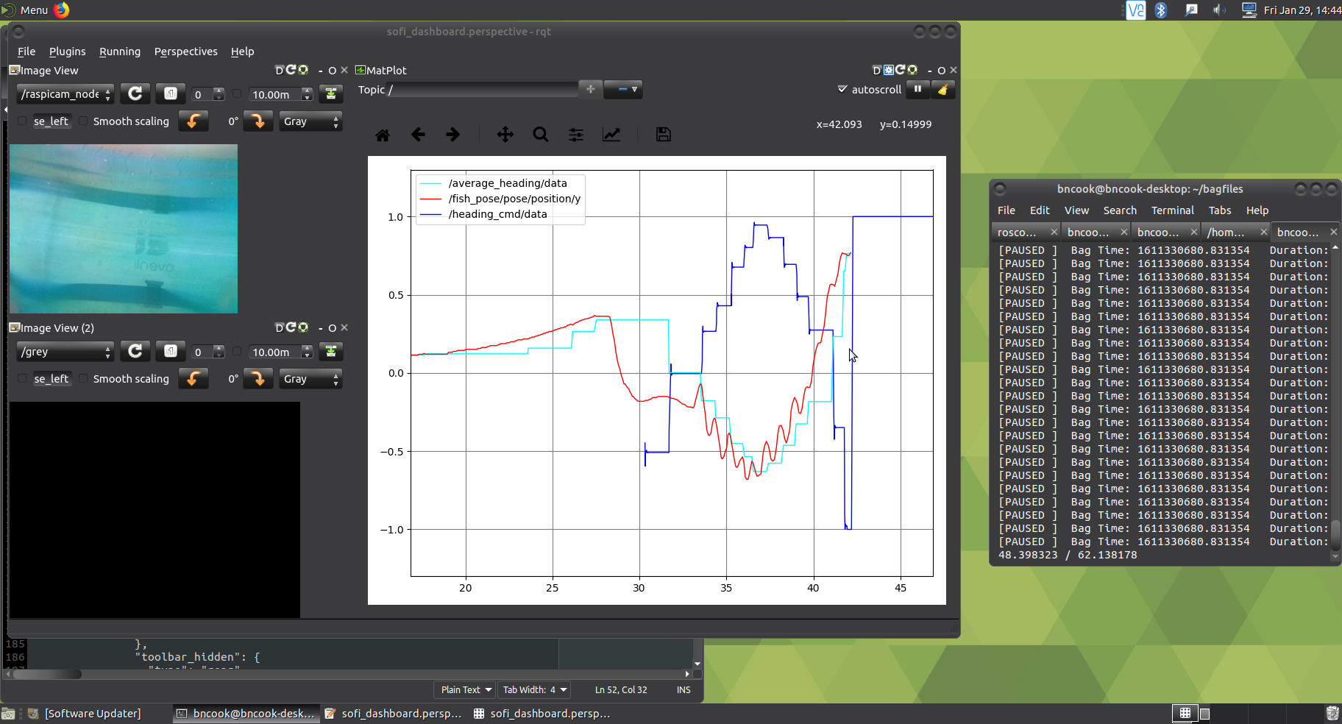
fish/pi/ros/catkin_ws/src/fishstatecontroller/graphs/test1.png
