arizonat/softroboticfish7/fish/pi/ros/catkin_ws/src/fishstatecontroller/graphs/test3.png

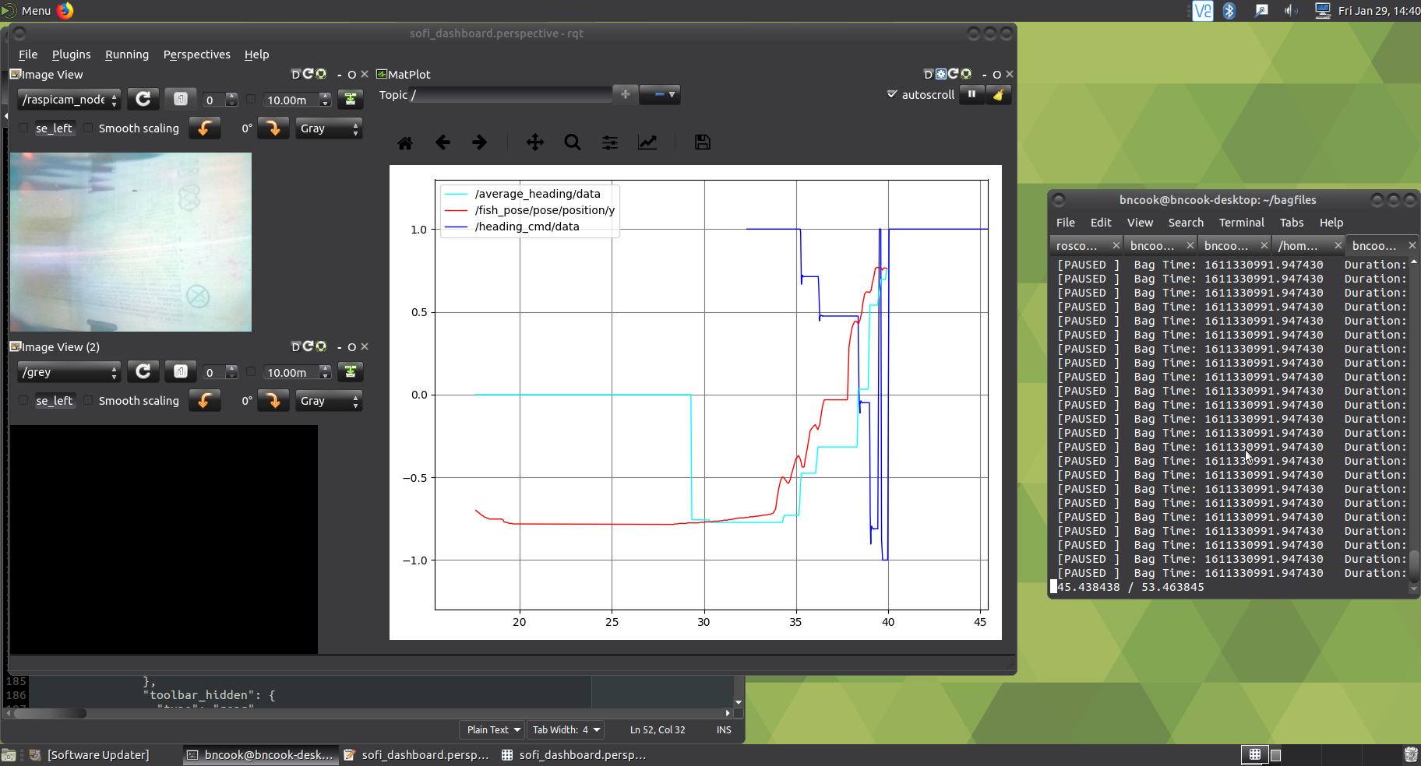
fish/pi/ros/catkin_ws/src/fishstatecontroller/graphs/test3.png
