arizonat/softroboticfish7/hardware/Projects/SRF V2/V2_2 (MAX14870)/PCBWay/Issue Resolution/D1、D2、C19、C21 anode and cathodes.png

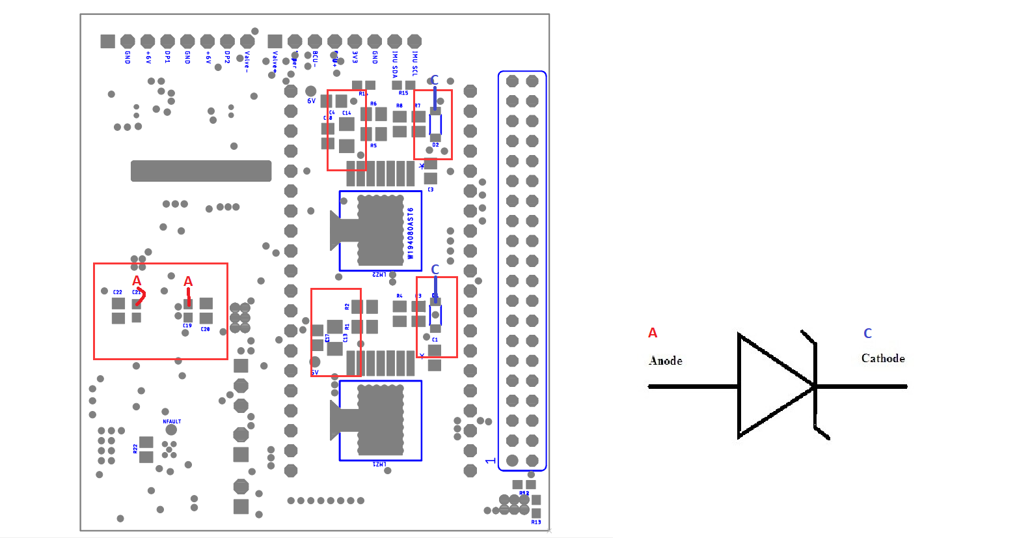
hardware/Projects/SRF V2/V2_2 (MAX14870)/PCBWay/Issue Resolution/D1、D2、C19、C21 anode and cathodes.png
