arizonat/softroboticfish7/hardware/Projects/SRF V2/V2_1 (DRV8801)/DXF Exports/scaled_dxf.pdf

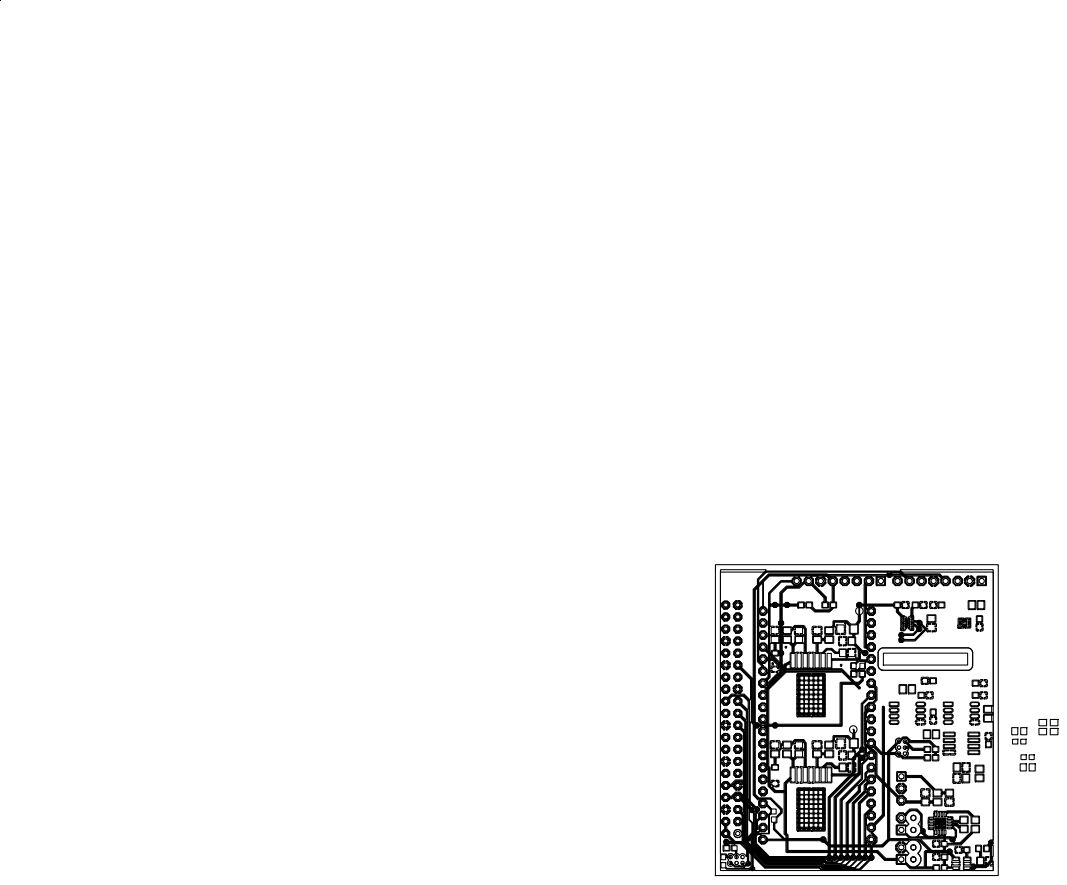
[picture p18: page 1]
