arizonat/softroboticfish7/hardware/Projects/SRF V2/V2_2 (MAX14870)/sofi_v7_main_rev2_2.brd

## EAGLE design hardware/Projects/SRF V2/V2_2 (MAX14870)/sofi_v7_main_rev2_2.brd (2020-06-26)

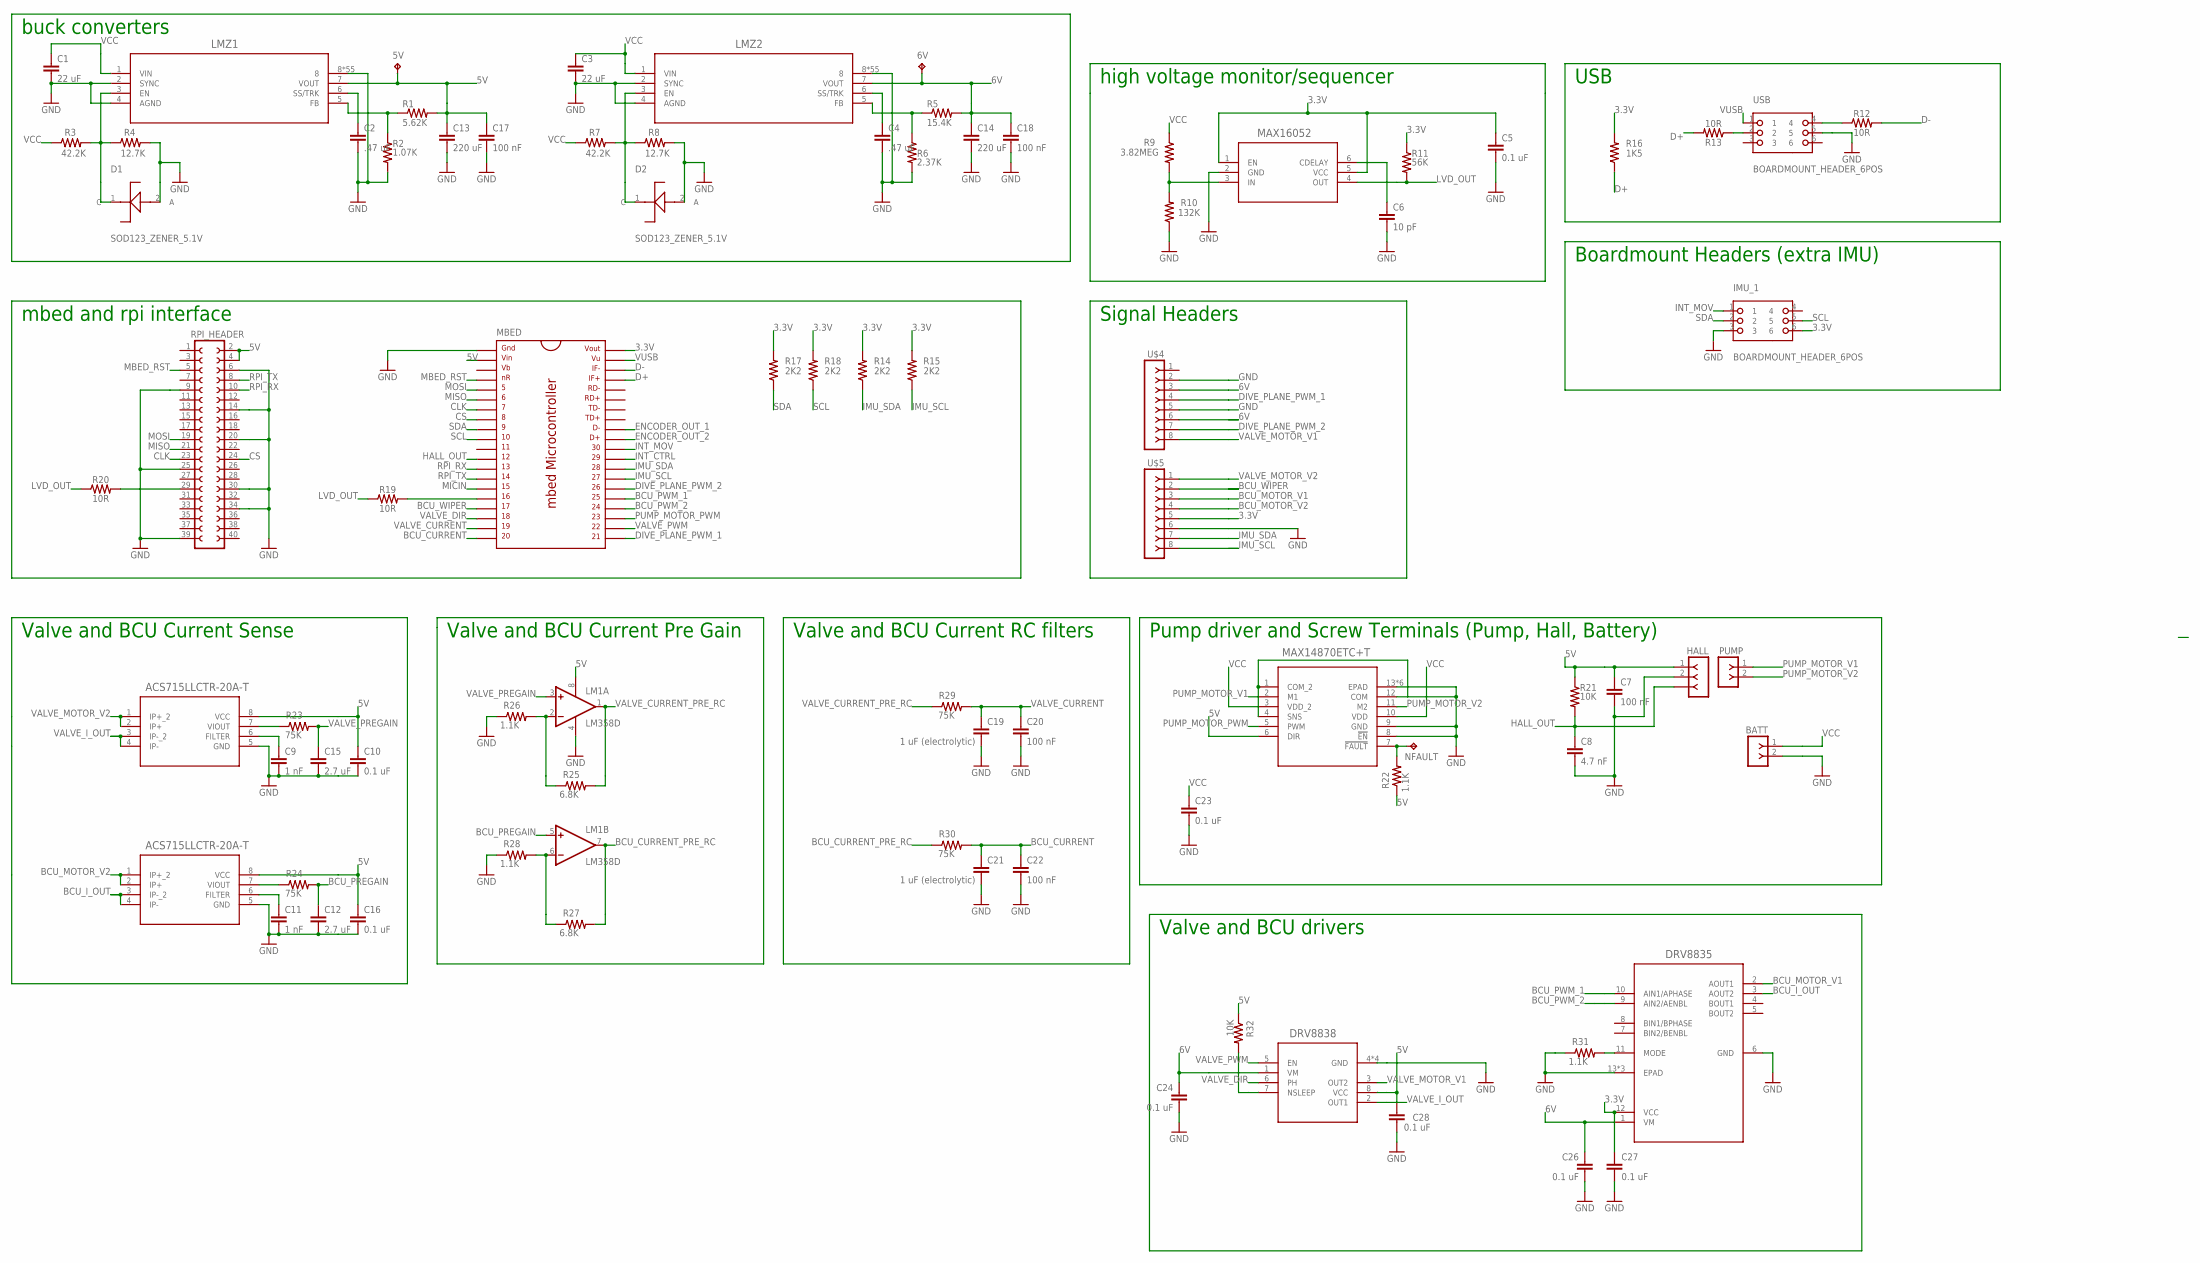
[picture p19: schematic sofi_v7_main_rev2_2.sch]

Parts:
5V, 6V: TPB1,27; B1,27
ACS715_BCU, ACS715_VALVE: ACS715LLCTR-20A-T; SOIC-8
BATT: 2POS_BLOCK2POS_BLOCK_NOSTANDS; 2POS_BLOCK_NOSTANDS
C1, C3: 22 uF; C0805
C2, C4: .47 uF; C0805
C5, C23: 0.1 uF; C0805
C6: 10 pF; C0603
C7, C17, C18, C20, C22: 100 nF; C0805
C8: 4.7 nF; C0805
C9, C11: 1 nF; C0603
C10, C16, C24, C26, C27, C28: 0.1 uF; C0603
C12, C15: 2.7 uF; C0603
C13, C14: 220 uF; C1206
C19, C21: 1 uF (electrolytic); C0603
D1, D2: SOD123_ZENER_5.1V; SOD123_ZENER
DRV8835: DRV8835DSSRDSS12_P9X2_THERMAL_EXTENDED; DSS12_P9X2_THERMAL_EXTENDED
DRV8838: DRV8838DSGTDSG8_P9X1P6_THERMAL_EXTENDED; DSG8_P9X1P6_THERMAL_EXTENDED
HALL: 3POS_TERMINAL
IMU_1: BOARDMOUNT_HEADER_6POS; BOARDMOUNT_HEADER
LM1: LM358D; SO08
LMZ1, LMZ2: LMZ23605TZE/NOPBTZA07A_THERMAL_TABBED; TZA07A_THERMAL_TABBED
MAX14870: MAX14870ETC+T; 21-0664B
MAX16052: MAX16052AUT+T; 21-0058I
MBED: MBED_MICROCONTROLLER; DIL40_0.9
NFAULT: TPB1,27; B1,27
PUMP: 2POS_BLOCK2POS_BLOCK_NOSTANDS; 2POS_BLOCK_NOSTANDS
R1: 5.62K; M0805
R2: 1.07K; M0805
R3, R7: 42.2K; M0805
R4, R8: 12.7K; M0805
R5: 15.4K; M0805
R6: 2.37K; M0805
R9: 3.82MEG; 0603
R10: 132K; 0603
R11: 56K; R0603
R12, R13, R19, R20: 10R; 0603
R14, R15, R17, R18: 2K2; 0603
R16: 1K5; 0603
R21, R32: 10K; M0805
R22, R26, R28, R31: 1.1K; M0805
R23, R24, R29, R30: 75K; M0805
R25, R27: 6.8K; M0805
RPI_HEADER: FE20-2
U$4, U$5: 8POS_TERMINAL
USB: BOARDMOUNT_HEADER_6POS; BOARDMOUNT_HEADER

Connections:
3.3V: C5.1, C27.1, DRV8835.12 (VCC), IMU_1.6, MAX16052.1 (EN), MAX16052.5 (VCC), MBED.40, R11.1, R14.2, R15.2, R16.2, R17.2, R18.2, U$5.5
5V: 5V.TP, ACS715_BCU.8 (VCC), ACS715_VALVE.8 (VCC), C7.1, C10.1, C13.1, C16.1, C17.1, C28.1, DRV8838.8 (VCC), HALL.1, LM1.8 (V+), LMZ1.7 (VOUT), MAX14870.6 (DIR), MBED.2, R1.2, R21.1, R22.1, R32.1, RPI_HEADER.2, RPI_HEADER.4
6V: 6V.TP, C14.1, C18.1, C24.1, C26.1, DRV8835.1 (VM), DRV8838.1 (VM), LMZ2.7 (VOUT), R5.2, U$4.3, U$4.6
BCU_CURRENT: C21.1, C22.1, MBED.20, R30.2
BCU_CURRENT_PRE_RC: LM1.7 (OUT), R27.2, R30.1
BCU_I_OUT: ACS715_BCU.3 (IP-_2), ACS715_BCU.4 (IP-), DRV8835.3 (AOUT2)
BCU_MOTOR_V1: DRV8835.2 (AOUT1), U$5.3
BCU_MOTOR_V2: ACS715_BCU.1 (IP+_2), ACS715_BCU.2 (IP+), U$5.4
BCU_PREGAIN: C12.1, LM1.5 (+IN), R24.2
BCU_PWM_1: DRV8835.10 (AIN1/APHASE), MBED.25
BCU_PWM_2: DRV8835.9 (AIN2/AENBL), MBED.24
BCU_WIPER: MBED.17, U$5.2
CLK: MBED.7, RPI_HEADER.23
CS: MBED.8, RPI_HEADER.24
D+: MBED.37, R13.2, R16.1
D-: MBED.38, R12.2
DIVE_PLANE_PWM_1: MBED.21, U$4.4
DIVE_PLANE_PWM_2: MBED.26, U$4.7
ENCODER_OUT_1: MBED.32
ENCODER_OUT_2: MBED.31
GND: ACS715_BCU.5 (GND), ACS715_VALVE.5 (GND), BATT.2, C1.2, C2.2, C3.2, C4.2, C5.2, C6.2, C7.2, C8.2, C9.2, C10.2, C11.2, C12.2, C13.2, C14.2, C15.2, C16.2, C17.2, C18.2, C19.2, C20.2, C21.2, C22.2, C23.2, C24.2, C26.2, C27.2, C28.2, D1.2 (A), D2.2 (A), DRV8835.6 (GND), DRV8835.13 (EPAD), DRV8835.P$1 (EPAD), DRV8835.P$2 (EPAD), DRV8838.4 (GND), DRV8838.9 (GND), DRV8838.P$1 (GND), DRV8838.P$2 (GND), HALL.2, IMU_1.3, LM1.4 (V-), LMZ1.2 (SYNC), LMZ1.4 (AGND), LMZ1.8, LMZ1.P$1 (8), LMZ1.P$2 (8), LMZ1.P$3 (8), LMZ1.P$4 (8), LMZ1.P$5 (8), LMZ1.P$6 (8), LMZ1.P$7 (8), LMZ1.P$8 (8), LMZ1.P$9 (8), LMZ1.P$10 (8), LMZ1.P$11 (8), LMZ1.P$12 (8), LMZ1.P$13 (8), LMZ1.P$14 (8), LMZ1.P$15 (8), LMZ1.P$16 (8), LMZ1.P$17 (8), LMZ1.P$18 (8), LMZ1.P$19 (8), LMZ1.P$20 (8), LMZ1.P$21 (8), LMZ1.P$22 (8), LMZ1.P$23 (8), LMZ1.P$24 (8), LMZ1.P$25 (8), LMZ1.P$26 (8), LMZ1.P$27 (8), LMZ1.P$28 (8), LMZ1.P$29 (8), LMZ1.P$30 (8), LMZ1.P$31 (8), LMZ1.P$32 (8), LMZ1.P$33 (8), LMZ1.P$34 (8), LMZ1.P$35 (8), LMZ1.P$36 (8), LMZ1.P$37 (8), LMZ1.P$38 (8), LMZ1.P$39 (8), LMZ1.P$40 (8), LMZ1.P$41 (8), LMZ1.P$42 (8), LMZ1.P$43 (8), LMZ1.P$44 (8), LMZ1.P$45 (8), LMZ1.P$46 (8), LMZ1.P$47 (8), LMZ1.P$48 (8), LMZ1.P$49 (8), LMZ1.P$50 (8), LMZ1.P$51 (8), LMZ1.P$52 (8), LMZ1.P$53 (8), LMZ1.P$54 (8), LMZ2.2 (SYNC), LMZ2.4 (AGND), LMZ2.8, LMZ2.P$1 (8), LMZ2.P$2 (8), LMZ2.P$3 (8), LMZ2.P$4 (8), LMZ2.P$5 (8), LMZ2.P$6 (8), LMZ2.P$7 (8), LMZ2.P$8 (8), LMZ2.P$9 (8), LMZ2.P$10 (8), LMZ2.P$11 (8), LMZ2.P$12 (8), LMZ2.P$13 (8), LMZ2.P$14 (8), LMZ2.P$15 (8), LMZ2.P$16 (8), LMZ2.P$17 (8), LMZ2.P$18 (8), LMZ2.P$19 (8), LMZ2.P$20 (8), LMZ2.P$21 (8), LMZ2.P$22 (8), LMZ2.P$23 (8), LMZ2.P$24 (8), LMZ2.P$25 (8), LMZ2.P$26 (8), LMZ2.P$27 (8), LMZ2.P$28 (8), LMZ2.P$29 (8), LMZ2.P$30 (8), LMZ2.P$31 (8), LMZ2.P$32 (8), LMZ2.P$33 (8), LMZ2.P$34 (8), LMZ2.P$35 (8), LMZ2.P$36 (8), LMZ2.P$37 (8), LMZ2.P$38 (8), LMZ2.P$39 (8), LMZ2.P$40 (8), LMZ2.P$41 (8), LMZ2.P$42 (8), LMZ2.P$43 (8), LMZ2.P$44 (8), LMZ2.P$45 (8), LMZ2.P$46 (8), LMZ2.P$47 (8), LMZ2.P$48 (8), LMZ2.P$49 (8), LMZ2.P$50 (8), LMZ2.P$51 (8), LMZ2.P$52 (8), LMZ2.P$53 (8), LMZ2.P$54 (8), MAX14870.1 (COM_2), MAX14870.4 (SNS), MAX14870.8 (!EN), MAX14870.9 (GND), MAX14870.12 (COM), MAX14870.13 (EPAD), MAX14870.14 (EPAD), MAX14870.15 (EPAD), MAX14870.16 (EPAD), MAX14870.17 (EPAD), MAX14870.18 (EPAD), MAX16052.2 (GND), MBED.1, R2.2, R4.2, R6.2, R8.2, R10.1, R26.1, R28.1, R31.1, RPI_HEADER.6, RPI_HEADER.9, RPI_HEADER.14, RPI_HEADER.20, RPI_HEADER.25, RPI_HEADER.30, RPI_HEADER.34, RPI_HEADER.39, U$4.2, U$4.5, U$5.6, USB.5
HALL_OUT: C8.1, HALL.3, MBED.12, R21.2
IMU_SCL: MBED.27, R15.1, U$5.8
IMU_SDA: MBED.28, R14.1, U$5.7
INT_CTRL: MBED.29
INT_MOV: IMU_1.1, MBED.30
LVD_OUT: MAX16052.4 (OUT), R11.2, R19.1, R20.1
MBED_RST: MBED.4, RPI_HEADER.5
MICIN: MBED.15
MISO: MBED.6, RPI_HEADER.21
MOSI: MBED.5, RPI_HEADER.19
unnamed: R20.2, RPI_HEADER.29
unnamed: MAX14870.7 (!FAULT), NFAULT.TP, R22.2
unnamed: LMZ1.5 (FB), R1.1, R2.1
unnamed: MAX16052.3 (IN), R9.2, R10.2
unnamed: D1.1 (C), LMZ1.3 (EN), R3.2, R4.1
unnamed: C4.1, LMZ2.6 (SS/TRK)
unnamed: LMZ2.5 (FB), R5.1, R6.1
unnamed: C2.1, LMZ1.6 (SS/TRK)
unnamed: C6.1, MAX16052.6 (CDELAY)
unnamed: D2.1 (C), LMZ2.3 (EN), R7.2, R8.1
unnamed: ACS715_VALVE.7 (VIOUT), R23.1
unnamed: ACS715_VALVE.6 (FILTER), C9.1
unnamed: MBED.16, R19.2
unnamed: ACS715_BCU.7 (VIOUT), R24.1
unnamed: ACS715_BCU.6 (FILTER), C11.1
unnamed: LM1.2 (-IN), R25.1, R26.2
unnamed: R12.1, USB.4
unnamed: LM1.6 (-IN), R27.1, R28.2
unnamed: R13.1, USB.2
unnamed: DRV8835.11 (MODE), R31.2
unnamed: DRV8838.7 (NSLEEP), R32.2
PUMP_MOTOR_PWM: MAX14870.5 (PWM), MBED.23
PUMP_MOTOR_V1: MAX14870.2 (M1), PUMP.1
PUMP_MOTOR_V2: MAX14870.11 (M2), PUMP.2
RPI_RX: MBED.13, RPI_HEADER.10
RPI_TX: MBED.14, RPI_HEADER.8
SCL: IMU_1.5, MBED.10, R18.1
SDA: IMU_1.2, MBED.9, R17.1
VALVE_CURRENT: C19.1, C20.1, MBED.19, R29.2
VALVE_CURRENT_PRE_RC: LM1.1 (OUT), R25.2, R29.1
VALVE_DIR: DRV8838.6 (PH), MBED.18
VALVE_I_OUT: ACS715_VALVE.3 (IP-_2), ACS715_VALVE.4 (IP-), DRV8838.2 (OUT1)
VALVE_MOTOR_V1: DRV8838.3 (OUT2), U$4.8
VALVE_MOTOR_V2: ACS715_VALVE.1 (IP+_2), ACS715_VALVE.2 (IP+), U$5.1
VALVE_PREGAIN: C15.1, LM1.3 (+IN), R23.2
VALVE_PWM: DRV8838.5 (EN), MBED.22
VCC: BATT.1, C1.1, C3.1, C23.1, LMZ1.1 (VIN), LMZ2.1 (VIN), MAX14870.3 (VDD_2), MAX14870.10 (VDD), R3.1, R7.1, R9.1
VUSB: MBED.39, USB.1

Notes on the sheet:
mbed and rpi interface
buck converters
high voltage monitor/sequencer
Valve and BCU Current RC filters
Valve and BCU Current Pre Gain
Valve and BCU Current Sense
Signal Headers
USB
Pump driver and Screw Terminals (Pump, Hall, Battery)
Valve and BCU drivers
Boardmount Headers (extra IMU)

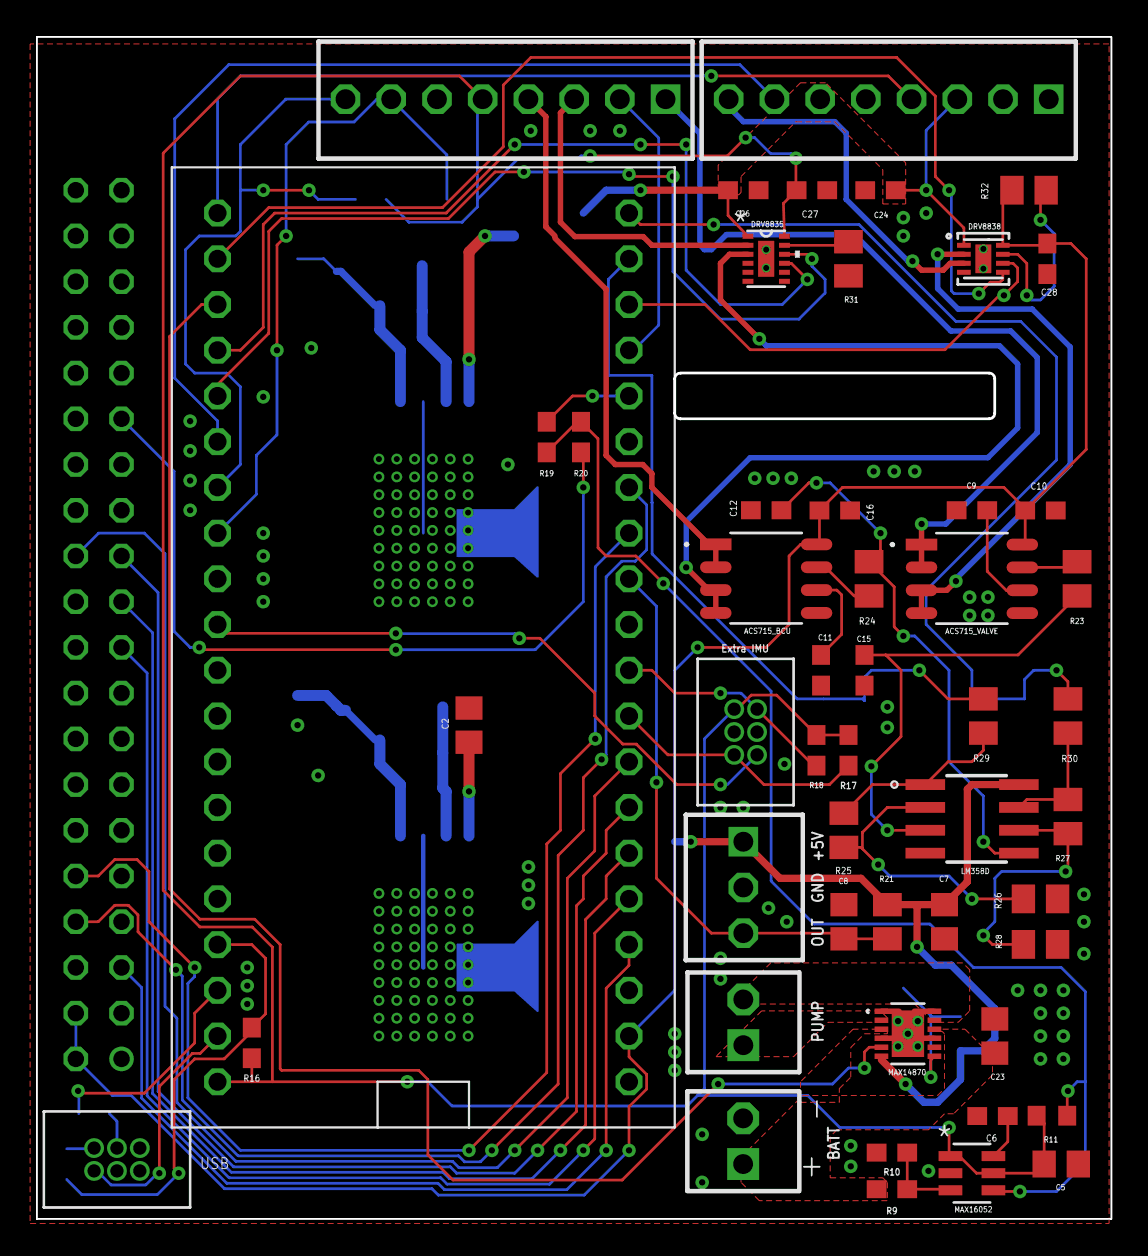
[picture p20: board sofi_v7_main_rev2_2.brd from above]

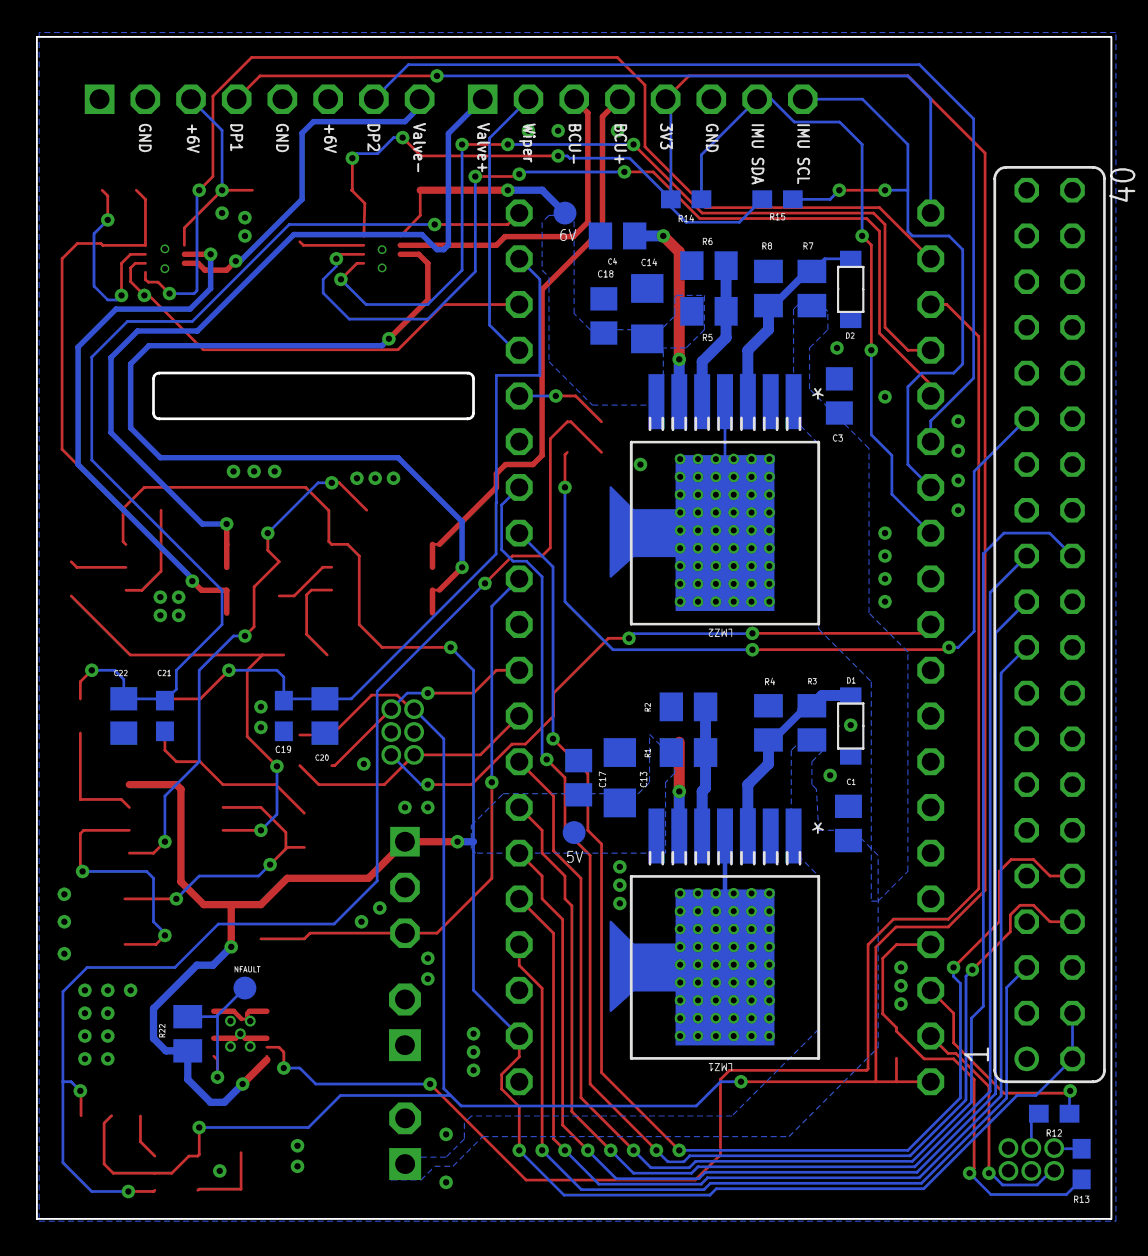
[picture p21: board sofi_v7_main_rev2_2.brd from below]

Board: 2 copper layers, 59.7 x 65.7 mm, 82 parts (32 on the bottom side), 65 nets.
