arizonat/softroboticfish7/fish/pi/ros/catkin_ws/src/fishstatecontroller/src/AutoControllerRos.py

#!/usr/bin/env python

import rospy
import roslib
import serial # see http://pyserial.readthedocs.org/en/latest/pyserial_api.html
#import fishcamera
from time import time, sleep
import time as clock
#from FishJoystick import FishJoystick
#from camera import FishCamera
from std_msgs.msg import String
from sensor_msgs.msg import Image
from geometry_msgs.msg import PoseStamped
import cv2
from cv_bridge import CvBridge
import numpy as np
from fishstatecontroller.msg import State, Position

CAM_OUTPUT_DIR="/home/pi/fish_recordings"
DISPLAY_IMAGES = False

class NaiveColorTargetTracker():
  def __init__(self, target_color):
    self.pub = rospy.Publisher('color_mask', Image, queue_size=10)
    #self.position_pub = rospy.Publisher('target_position', String, queue_size=10)
    self.target_color = target_color

    # Initiate position msg instance and new publisher for data
    self.position_msg = Position()
    self.position_pub = rospy.Publisher('fish_position', Position, queue_size=10)

    # Initiate instance for pose
    self.pose = PoseStamped()
    self.pose_pub = rospy.Publisher('fish_pose', PoseStamped, queue_size=10)

    # red stretches 2 bands in hsv
    # these values are for yellow, keeping the 2 bands for red in the future
    self.hsv_lower_lower = (rospy.get_param("/HSV_lower_val1"),rospy.get_param("/HSV_lower_val2"),rospy.get_param("/HSV_lower_val3")) #(14,55,55)
    self.hsv_lower_upper = (rospy.get_param("/HSV_upper_val1"),rospy.get_param("/HSV_upper_val2"),rospy.get_param("/HSV_upper_val3")) #(55,255,235)
    self.hsv_upper_lower = self.hsv_lower_lower
    self.hsv_upper_upper = self.hsv_lower_upper

    # amount to shrink image, maintains aspect ratio
    self.subsample_ratio = 0.25

    self.focal_length = 993.0               #the focal length of the camera
    self.real_height = 1.25                 #the real height of the target object
    self.image_center = (635.08, 469.80)    #the image center of the camera
    #cv2.namedWindow('Mask')

  def find_target(self, cv_image):
    #image = self.camera.capture()
    image = cv_image 	##CHANGED##
    target_found, target_centroid = self.process_image(image)
    return (target_found, target_centroid)

  def process_image(self, image):
    """
    Processes a single image, looks for a circle, return the target centroid in the camera frame
    Reference: https://www.pyimagesearch.com/2015/09/14/ball-tracking-with-opencv/
    """
    target_found = False
    target_centroid = None

    #Blur and resize the image, put into HSV color scale, and create an image mask
    img_small = cv2.resize(image, None, fx=self.subsample_ratio, fy=self.subsample_ratio, interpolation=cv2.INTER_LINEAR)
    img_small = cv2.GaussianBlur(img_small, (5,5), 0)
    hsv_small = cv2.cvtColor(img_small, cv2.COLOR_BGR2HSV)
    mask_l = cv2.inRange(hsv_small, self.hsv_lower_lower, self.hsv_lower_upper)
    mask_u = cv2.inRange(hsv_small, self.hsv_upper_lower, self.hsv_upper_upper)
    mask = cv2.bitwise_or(mask_l, mask_u)
    #mask = cv2.erode(mask, None, iterations=2)
    #mask = cv2.dilate(mask, None, iterations=2)

    #Publish the mask
    mask_bgr8 = cv2.cvtColor(mask,cv2.COLOR_GRAY2BGR)
    bridge = CvBridge()
    cv_mask = bridge.cv2_to_imgmsg(mask_bgr8, encoding='bgr8')
    self.pub.publish(cv_mask)

    #find the largest contour of the mask or return False,None if target is not there
    cnts, cnt_hier = cv2.findContours(mask.copy(), cv2.RETR_EXTERNAL,cv2.CHAIN_APPROX_SIMPLE)[-2:]
    if len(cnts) == 0:
      return (False, None)
    cnt = max(cnts, key=cv2.contourArea)
    ((x,y),radius) = cv2.minEnclosingCircle(cnt)

    if DISPLAY_IMAGES:
      mask = cv2.circle(mask,(int(x),int(y)), int(radius), (255,0,0))
      cv2.imshow('Mask',mask)
      cv2.waitKey(1)
    #print(img_small.shape)
    #print("%d, %d, %d"%(hsv_small[60,80,0],hsv_small[60,80,1],hsv_small[60,80,2]))
    #print(radius)
    if radius < 5:
      return (False, None)

    target_centroid = ((int(x/self.subsample_ratio),int(y/self.subsample_ratio)),int(radius/self.subsample_ratio))
    target_found = True

    #Calculate the object's distance and offset from center
    height_px =  2 * target_centroid[1]
    offset_px = -1.0*(target_centroid[0][0] - self.image_center[0]) , -1.0*(target_centroid[0][1] - self.image_center[1])
    distance = (self.focal_length * self.real_height) / height_px
    y_offset = (offset_px[0] * distance)/self.focal_length
    z_offset = (offset_px[1] * distance)/self.focal_length

    #Publish the distance and offset information
    #position_buffer = "DIST, OFFSET: " + str(distance) + ", (" + str(x_offset) + "," + str(y_offset) + ")"
    #self.position_pub.publish(position_buffer)
    #return (target_found, target_centroid)

    # Publish distance and offset information to message file instead
    self.position_msg.distance = str(distance)
    self.position_msg.x_offset = str(z_offset)
    self.position_msg.y_offset = str(y_offset)
    self.position_pub.publish(self.position_msg)

    #Publishing a pose message
    self.pose.header.seq = 1
    self.pose.header.stamp = rospy.Time.now()
    self.pose.header.frame_id = "sofi_cam"
    self.pose.pose.position.x = distance
    self.pose.pose.position.y = y_offset
    self.pose.pose.position.z = z_offset
    self.pose.pose.orientation.x = 0
    self.pose.pose.orientation.y = 0
    self.pose.pose.orientation.z = 0
    self.pose.pose.orientation.w = 1

    self.pose_pub.publish(self.pose)
    #self.mbed._mbedSerial.write(self.pose)

    return (target_found, target_centroid)

class FishMbed():
  def __init__(self, mbedPort='/dev/ttyACM0', mbedBaud=115200, mbedUpdateInterval=1.25):
    self.cmd_arr_order = ['start', 'pitch', 'yaw', 'thrust', 'frequency']

    self._mbedSerial = serial.Serial(mbedPort, baudrate=mbedBaud, timeout=None, bytesize=serial.EIGHTBITS, parity = serial.PARITY_NONE, stopbits = serial.STOPBITS_ONE)
    self._mbedUpdateInterval = mbedUpdateInterval

    self.CMD_MAX = 255
    self.CMD_MIN = 1

  def writeCmdArray(self, cmd):
    bytecmds = self.safeCmdToBytes(cmd)
    self.writeBytes(bytecmds)

  def writeBytes(self, bytecmds):
    self._mbedSerial.write(bytecmds)
    if bytecmds[-1] != 0:
      self._mbedSerial.write(bytearray([0]))
    self._mbedSerial.flush()

  def safeCmdToBytes(self, cmd, cmdType='byteArray', nullTerminate=False):

    if cmdType == "byteArray":
      for i,val in enumerate(cmd):
        cmd[i] = max(min(cmd[i],self.CMD_MAX),self.CMD_MIN)
    elif cmdType == "dict":
      for k in self.self.cmd_arr_order:
        cmd[k] = max(min(cmd[k],self.CMD_MAX),self.CMD_MIN)

    return self.cmdToBytes(cmd, cmdType, nullTerminate)

  def cmdToBytes(self, cmd, cmdType='byteArray', nullTerminate=False):
    #Turns a fish mbed command to bytearray (for sending to mbed)
    if cmdType == "dict":
      res = [cmd[cmd_key] for cmd_key in self.cmd_arr_order]
    else:
      res = cmd

    assert(len(res) == len(self.cmd_arr_order))
    if nullTerminate:
      res.append(0)
    return bytearray(res)

class FishStateController():
  def __init__(self, update_interval):
    """
    update_interval in seconds
    """
    self.state_msg = State()
    self.state_pub = rospy.Publisher('fish_state', State, queue_size=10)
    #self.state_pub = rospy.Publisher('fish_state', String, queue_size=10)

    self.states = ("INIT","SEARCH","ADJUST","FOLLOW")
    self.state = None
    self.state_init_time = None
    self.follow_timeout = 5

    #['start', 'pitch', 'yaw', 'thrust', 'frequency']
    #[pitch: 0-6, yaw:0-6, thrust: 0-3, frequency: 0-3]

    self.STARTUP = [1,1,1,1,1]

    self.HARD_LEFT = [255,135,255,255,170]
    self.HARD_RIGHT = [255,135,1,255,170]
    self.SOFT_LEFT = [255,135,220,255,170]
    self.SOFT_RIGHT = [255,135,45,255,170]
    self.DO_NOTHING = [255,135,135,1,85]
    self.GO_FORWARD = [255,135,135,255,255]

    self.transitionTo("INIT")

    self.update_interval = update_interval

    self.mbed = FishMbed()
    self.image = np.zeros((960,1280,3), np.uint8)	##CHANGED##
    #self.camera = cv2.VideoCapture(0)
    #self.camera = FishCamera(CAM_OUTPUT_DIR)
    target_rgb = (255,0,0)
    self.tracker = NaiveColorTargetTracker(target_rgb)
    self.image_size = self.image.shape

  def run(self):
    lastTime = time()

    while True:
      if time() - lastTime > self.update_interval:
        lastTime = time()
        self.runOnce()

  def transitionTo(self, state_name):
    self.state = state_name
    self.state_init_time = time()
    print(self.state)

    ###Can use below if adjust direction not important.
    #self.state_msg.header.stamp = rospy.Time.now()
    #self.state_msg.state = self.state
    #self.state_pub.publish(self.state_msg)

  def runOnce(self):
    # Mbed command order: ['start', 'pitch', 'yaw', 'thrust', 'frequency']
    target_found, target_centroid = self.tracker.find_target(self.image)	##CHANGED##
    self.state_msg.adjust = "NO ADJUST"

    if self.state == "INIT":
      self.mbed.writeCmdArray(self.STARTUP)
      sleep(15)
      #self.mbed.writeCmdArray(self.DO_NOTHING)
      self.transitionTo("SEARCH")

    elif self.state == "SEARCH":

      if target_found:
        self.transitionTo("ADJUST")
        self.state_msg.adjust = "ADJUST"
        return

      self.mbed.writeCmdArray(self.HARD_LEFT)

    elif self.state == "ADJUST":
      # higher yaw is right, lower is left
      target_found, target_centroid = self.tracker.find_target(self.image)
      """
      if target_found and target_centroid[0][0] >= self.image_size[1]*(2./3.):
        self.state_msg.adjust = "SOFT RIGHT"
        print("SOFT RIGHT: %d, %d"%(target_centroid[0][0], self.image_size[1]*(2./3.)))
        self.mbed.writeCmdArray(self.SOFT_RIGHT)
      elif target_found and target_centroid[0][0] <= self.image_size[1]*(1./3.):
        self.state_msg.adjust = "SOFT LEFT"
        print("SOFT LEFT: %d, %d"%(target_centroid[0][0], self.image_size[1]*(1./3.)))
        self.mbed.writeCmdArray(self.SOFT_LEFT)
      #Alternative to above if statement that uses pose to determine whether soft right or left should be taken
      ###
      """
      if target_found and self.tracker.pose.pose.position.y < -1 and self.tracker.pose.pose.position.y > -3:
        self.state_msg.adjust = "SOFT RIGHT"
        print("SOFT RIGHT: %d mm"%(self.tracker.pose.pose.position.y))
        self.mbed.writeCmdArray(self.SOFT_RIGHT)
      elif target_found and self.tracker.pose.pose.position.y > 1 and self.tracker.pose.pose.position.y < 3:
        self.state_msg.adjust = "SOFT LEFT"
        print("SOFT LEFT: %d mm"%(self.tracker.pose.pose.position.y))
        self.mbed.writeCmdArray(self.SOFT_LEFT)
      elif target_found and self.tracker.pose.pose.position.y <= -3:
        self.state_msg.adjust = "HARD RIGHT"
        print("HARD RIGHT: %d mm"%(self.tracker.pose.pose.position.y))
        self.mbed.writeCmdArray(self.HARD_RIGHT)
      elif target_found and self.tracker.pose.pose.position.y >= 3:
        self.state_msg.adjust = "HARD LEFT"
        print("HARD LEFT: %d mm"%(self.tracker.pose.pose.position.y))
        self.mbed.writeCmdArray(self.HARD_LEFT)
      ###
      elif target_found:
        self.transitionTo("FOLLOW")
      else:
        self.transitionTo("SEARCH")

    elif self.state == "FOLLOW":

      if time() - self.state_init_time > self.follow_timeout:
        self.transitionTo("SEARCH")
        return
      self.mbed.writeCmdArray(self.GO_FORWARD)

    self.state_msg.state = self.state
    self.state_msg.header.stamp = rospy.Time.now()
    self.state_pub.publish(self.state_msg)

  def callback(self, ros_data):		##CHANGED##
    ###Put CV2 information here to analyze image data ###
    bridge = CvBridge()
    cv_image = bridge.imgmsg_to_cv2(ros_data, desired_encoding='passthrough')
    self.image = cv_image
    #print(cv_image)

if __name__ == '__main__':
  import sys
  update_hz = 30
  rospy.init_node('listener', anonymous=True)
  controller = FishStateController(1./update_hz)
  rospy.Subscriber('/raspicam_node/image', Image, controller.callback)
  print '\nStarting Fish State Controller'
  print 'using update interval of ', 1./update_hz, 's'
  controller.run()
  print '\nAll done!'
  rospy.spin()
