arizonat/softroboticfish7/fish/pi/bluetooth_joystick/BluetoothJoystickController.py

import serial # see http://pyserial.readthedocs.org/en/latest/pyserial_api.html
from time import time, sleep
from FishJoystick import FishJoystick


class BluetoothJoystickController:
  # @param mbedPort [str] The serial port to use on the mbed
  # @param mbedBaud [int] The baud rate to use with the mbed
  # @param mbedUpdateInterval [float] Time in ms to wait between sending updated state to the mbed
  # Raspbian: /dev/ttyAMA0, Ubuntu MATE 18.04: /dev/serial0
  # In order for this to run, you need at least one USB device plugged into the Pi (try mouse or keyboard).
  def __init__(self, mbedPort='/dev/serial0', mbedBaud=115200, mbedUpdateInterval=1.25 , useLJ = True):
    self._mbedSerial = serial.Serial(mbedPort, baudrate=mbedBaud, timeout=None, bytesize=serial.EIGHTBITS, parity = serial.PARITY_NONE, stopbits = serial.STOPBITS_ONE) # timeout = None means blocking, timeout = 0 means non-blocking
    self._mbedUpdateInterval = mbedUpdateInterval
    self._joystick = FishJoystick(joystick='snes', useLJ=useLJ)

  # The main loop to update state from joystick and send to mbed
  # @param runTime [flaot or None] The time to run for, or None for infinite loop
  def run(self, runTime=None):
    self._mbedSerial.flushInput()
    self._mbedSerial.flushOutput()
    lastSendTime = 0
    lastPrintTime = 0
    startTime = time()    
    while runTime is None or time() - startTime < runTime:
      self._joystick.scan()
      sleep(0.01) # not sure if this is needed, but seems nice to reduce polling load on device?
      if time() - lastSendTime > self._mbedUpdateInterval:
        stateBytes = self._joystick.getStateBytes('bytearray')
        self._mbedSerial.write(stateBytes)
        #self._mbedSerial.write(bytearray([1, 1, 1, 1, 1, 0]))
        if stateBytes[-1] != 0:
          self._mbedSerial.write(bytearray([0]))
        self._mbedSerial.flush() # wait until everything is written
        lastSendTime = time()
      if time() - lastPrintTime > 1:
       print self._joystick.getStateBytes('dict')
       lastPrintTime = time()


if __name__ == '__main__':
  import sys
  
  #try:
  #  mbedUpdateInterval = float(sys.argv[1])
  #except:
  #  mbedUpdateInterval = 0.01
  
  controller = BluetoothJoystickController(useLJ = False)
  print '\nStarting controller'
  print 'using update interval of ', 0.05, 's'
  controller.run()
  print '\nAll done!'
