arizonat/softroboticfish7/fish/mbed/LPCExpress/IMU_Test/main.cpp

#include "AdaBNO055.h"
#include "mbed.h"
//#include <cmath>

#define PIN_IMU_TX p28
#define PIN_IMU_RX p27

PwmOut calibrationLevel(LED1);
PwmOut pitch(LED2);
PwmOut roll(LED3);
PwmOut yaw(LED4);
BNO055 imu(PIN_IMU_TX, PIN_IMU_RX);
Serial pc(USBTX, USBRX);
DigitalOut powerIMU(p5);
LocalFileSystem local("local");


Vector quat_to_euler(Quaternion quat) {
    Vector euler;
  euler[0] = atan2(2*(quat.x*quat.y + quat.z*quat.w), 1 - (2*(quat.y*quat.y + quat.z*quat.z)));
  euler[1] = asin(2*(quat.x*quat.z - quat.y*quat.w));
  euler[2] = atan2(2*(quat.x*quat.w + quat.y*quat.z), 1 - (2*(quat.z*quat.z + quat.w*quat.w)));
  return euler;
}


int main() {
  // wait(10);
  Serial* pi = new Serial(p13, p14);
  pi->baud(115200);
  powerIMU = 0;
  wait(5);
  powerIMU = 1;
  bool needData = true;
  pc.printf("Starting the BNO055.\r\n");
  bool status = imu.begin(OPERATION_MODE_NDOF);
  pc.printf("SUCCESSFUL? %d\r\n", status);
  while(1) {
    // pc.printf("TEMP: %d\r\n", imu.getTemp());
    Vector euler; // = imu.getVector(VECTOR_EULER);
    unsigned char s, g, a, w;
    imu.getCalibration(&s, &g, &a, &w);
    for(int i = 0; i < 10; i++) {
      euler = imu.getVector(VECTOR_EULER);
      imu.getCalibration(&s, &g, &a, &w);
      calibrationLevel = (float)(s + g + a + w)/12.0;
      pitch = abs(euler[2]/180.0);
      roll = abs(euler[1]/180.0);
      yaw = abs((euler[0]-180.0)/180.0);
//      wait_ms(100);

    }
//    double tempfloat = 21.2;
    Vector gyro = imu.getVector(VECTOR_GYROSCOPE);
    Vector mag = imu.getVector(VECTOR_MAGNETOMETER);
    Vector acc = imu.getVector(VECTOR_LINEARACCEL);
    char calibration[22];
    bool goodData = imu.getSensorOffsets(calibration);
//    imu.setSensorOffsets(calibration);
    if(goodData && needData) {
//      imu.setSensorOffsets(calibration);
      FILE *fp = fopen("/local/calib", "w");
      for(int i = 0; i < 22; i++) {
        fprintf(fp, "%c", calibration[i]);

      }
      fclose(fp);
      needData = false;
    }
//    pc.printf("pitch: %.2f, roll: %.2f, yaw: %.2f, test: %.2f\r\n",euler[2], euler[1], euler[0], tempfloat);
//    pc.printf("gyro_pitch: %.2f, gyro_roll: %.2f, gyro_yaw: %.2f\r\n", gyro[0], gyro[1], gyro[2]);
//    pc.printf("acc_x: %.2f, acc_y: %.2f, acc_z: %.2f\r\n", acc[0], acc[1], acc[2]);
//    pc.printf("mag_x: %.2f, mag_y: %.2f, mag_z: %.2f\r\n", mag[0], mag[1], mag[2]);
    pc.printf("sys: %d, gyro: %d, accel: %d, mag: %d\r\n", s, g, a, w);
    // pc.printf("tempfloat: %.2f\r\n", tempfloat);

    /* Calculate heading in degrees, then angle to true North*/
    float heading = atan2(mag[1], mag[0]) * 180/3.1415;
    float declination = -6.92; //look up, based on location (latitude and longitude)
    float angle2TrueNorth = heading + declination;
//    pc.printf("Angle to true north: %.2f\r\n", angle2TrueNorth);
//    pi->printf("Angle to true north: %.2f\r\n", angle2TrueNorth);

//    pi->printf("%07.2f,%07.2f,%07.2f,%07.2f\n",euler[2], euler[1], euler[0], angle2TrueNorth);
    pi->printf("%07.2f,%07.2f,%07.2f,%07.2f,%07.2f,%07.2f,%07.2f,%07.2f,%07.2f,%07.2f\n",euler[2], euler[1], euler[0], gyro[0], gyro[1], gyro[2], acc[0], acc[1], acc[2], angle2TrueNorth);

//    pi->printf("%07.2f,%07.2f,%07.2f\n",euler[2], euler[1], euler[0]);
//    pc.printf("%07.2f,%07.2f,%07.2f\n",euler[2], euler[1], euler[0]);
//    wait(0.1);
    wait_ms(100);
  }

  return 0;
}
