arizonat/softroboticfish7/(commit log)

2020-06-02 added EAGLE CAD libraries for SoFi board parts
2020-06-12 added board files and libraries
    [SRF rev A BOM.xlsx, SRF rev A.xlsx, sofi_v7_main.brd, sofi_v7_main.sch, sofi_v7_main_rev2_1.brd, sofi_v7_main_rev2_1.dxf, sofi_v7_main_rev2_1.sch, sofi_v7_main_rev2_2.brd]
2020-06-15 added GND plane vias to minimize current return paths, modified 2POS_BLOCK lib
    [sofi_v7_main_rev2_2.brd, sofi_v7_main_rev2_2.sch]
2020-06-22 new motor driver footprints with extended pads, thermals test
    [sofi_v7_main_rev2_2.brd, sofi_v7_main_rev2_2.sch]
2020-06-22 "Made AutoController Node take camera images"
2020-06-22 added power planes for VCC to power modules, pump motor outputs
    [sofi_v7_main_rev2_2.brd, sofi_v7_main_rev2_2.sch]
2020-06-23 extended motor driver pads, removed top thermals on power module thermal vias
    [sofi_v7_main_rev2_2.brd, sofi_v7_main_rev2_2.sch]
2020-06-24 defined corner radius around camera cable cut-out, widened valve & bcu motor output traces for safety, rearranged some polygons
    [sofi_v7_main_rev2_2.brd]
2020-06-24 generated PCBWay gerbers, pick & place, saved BOM
    [PnP_sofi_v7_main_rev2_2_front_and_back.xlsx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]
2020-06-25 regenerated CAM outputs due to submission failure
    [PnP_sofi_v7_main_rev2_2_front_and_back.xlsx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]
2020-06-25 mbed -> pi wired serial works in log_serial_test.py, REMOVE ANY CONSOLE PARTS FROM /boot/cmdline.txt THAT RELATES TO SERIAL0
2020-06-26 fixed PCBWay drill size issue, removed thermals on LMZ pad for future revision, generated final CAM files
    [sofi_v7_main_rev2_2.brd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]
2020-07-03 fixed errors in state message publishing
    [AutoControllerRos.py]
2020-07-09 fixed minor error in NaiveColorTargetTracker.process_image; uncommented mbed code
    [AutoControllerRos.py]
2020-07-09 sign flip on the horizontal (y) offset
    [AutoControllerRos.py]
2020-07-10 changed to default mode (no auto mode, infinite serial loop, no debug printing)
2020-07-15 "Slight correction to speed adjust block"
    [AutoControllerRos.py]
2020-07-15 changed max frequency from 1.6 Hz to 1.2 Hz, changed serial input range to 1-255, changed terminating byte from 8 to 0 for new ranges, added new valve control debug helper functions
2020-07-17 added PCBWay issue resolution snapshots
2020-07-30 updated IMU_Test to include correct library
    [AdaBNO055.cpp, AdaBNO055.h, main.cpp]
2020-08-03 modified BCU and FishController for imu initialization setup
2020-08-07 "Now allows for control of motor on state"
2020-08-11 modified IMU test, added Vfreq constraint in PumpWithValve
2020-08-11 changed usbSerial to serial for wired UART
2020-08-12 started imu parsing
2020-08-13 added custom serial reading for IMU measurements in log_serial_test.py and serial_node.py
2020-08-13 fixed length of outgoing IMU data string in test script
    [main.cpp]
2020-08-13 serial_node now parses imu data into Imu messages and publishes
2020-08-14 added IMU compass heading measurements in serial_node.py, reverted log_serial_test back to old state, buffer serial now in log_imu_test.py
    [log_imu_test.py, serial_node.py]
2020-08-14 now sending pitch, roll, yaw, heading from IMU_Test
2020-08-17 Performed and recorded manual testing for the ObjectTracker; fixed minor errors
    [ObjectTracker.py]
2020-08-17 Changed tracker rate to 24hz (about as fast as it can go)
2020-08-20 Fixed small errors after testing the FishStateMachine and recorded manual testing notes
    [FishStateMachine.py]
2020-08-20 Created pid controller launch file
2020-08-21 Fixed bug occuring in ObjectTracker that would prevent the heading average from being calculated
    [ObjectTracker.py]
2020-08-25 changed imu topic to /imu/data, corrected IMU message publishing
    [serial_node.py]
2020-08-25 added new data elements into fixed string
    [log_imu_test.py, serial_node.py]
2020-08-31 Added pitch and distance feedback to PID controller and serial node
2020-08-31 Added pitch and distance feedback to ObjectTracker and FishStateMachine; minor fies in auto_controller.launch and serial node
2020-09-01 fixed degrees -> rad conversion for euler angles
    [serial_node.py]
2020-09-03 Changed scale of pid controller output from -10/+10 to -1/+1; minor bug fix in serial node
    [serial_node.py]
2020-09-10 updated IMU test code
2020-09-29 Fixed SEARCH state pattern
    [FishStateMachine.py]
2020-10-19 modified IMU test script, reverted fish valve parameters to original
    [FishController.h, PumpWithValve.h, SerialController.h, main.cpp]
2020-10-19 added calibration_parser file, which parses and stores camera info
2020-10-21 created new ObjectTracker_fusion.py for IMU + Camera fusion, wrote new TODOs and ROS pub/subs
2020-10-22 almost done w/ pubs, need to convert imu to twist
2020-10-23 first pass imu + cam implemented, saved robot_localization files
2020-10-23 added Imu pub in ObjectTracker_fusion.py
2020-10-23 ekf_imu_cam.yaml now configures imu, twist, and pose
2020-10-27 Created new raspicam_node resolution and calibration files
2020-11-16 State Controller current stage
2020-12-03 added new calibration file, removed subsampling from Object Tracker, implemted object tracking with header angle
2020-12-08 added IMU class
2020-12-08 updated IMU class
2020-12-09 modified IMU class
2020-12-10 added extra IMU helper functions
2020-12-17 Implemented area and color filter for blob tracker
2020-12-18 Added filtering to remove mirrored surface objects and fuzzy objects
2021-01-21 Fixed minor changes in manual controller and serial node; began writing visualization code
    [ManualController.py, Visualization.py, serial_node.py]
2021-01-27 added IMU data writes (ifdef) in SerialController
2021-01-29 Update BlobTracker_320x240.py
    Fixed an issue with over filtering of targets
    [BlobTracker_320x240.py]
2021-02-22 set pitch and thrust control to be off by default; added camera parameters
2021-02-28 Added a few more experiments for heading averaging, including what the ROS PID filter does maybe, though maybe not since it needs to operate on the derivative
2021-02-28 Implemented Braden filter for comparison
2021-03-05 implemented hack to filter fish head oscillations in PID node
    [BlobTracker_320x240.py]
2021-03-05 Added a fixed sample rate of Bradens filter and better print statements
2021-03-12 Added a heading setpoint to the launch faile
    [FishStateMachine.py]
2021-03-12 implemented low pass filter on state estimation
2021-04-30 adding gazebo model of nose cone
    [model.sdf]
