arizonat/softroboticfish7/(notices)

Notices in the files:
parts and their libraries:
SparkFun-Resistors: Licensing: Creative Commons ShareAlike 4.0 International - https://creativecommons.org/licenses/by-sa/4.0
MAX14870: COPYRIGHT: Copyright (C) 2018 Accelerated Designs. All rights reserved
